Rodrig087/Vertedero-PCh/Software/Arduino/im_circuito_arduino_nokia_5110.jpg

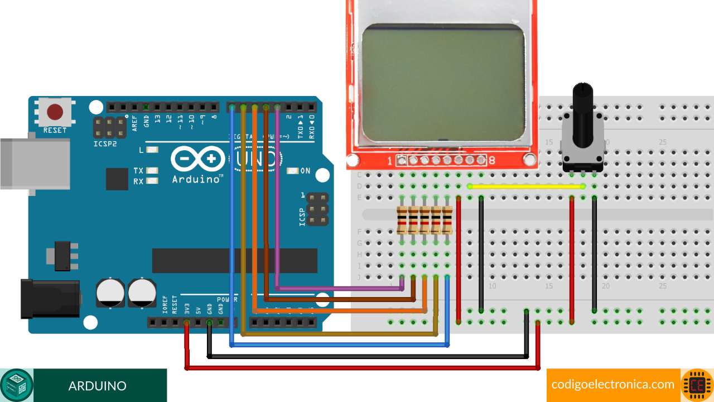
Software/Arduino/im_circuito_arduino_nokia_5110.jpg
