Rodrig087/Vertedero-PCh/LEEME.txt

Este repositorio contiene el firmware para los sensores de nivel del proyecto de monitorizacion de la presa.
