Rodrig087/Vertedero-PCh/Documentacion/Metodos de medicion de TOF.docx

Señal muestreada:

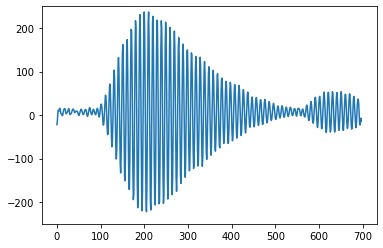
[picture p2: figure]

Método 1:

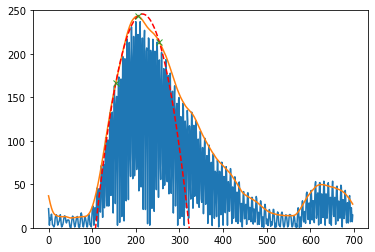
[picture p3: figure]

Método 2:

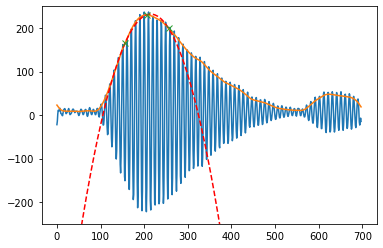
[picture p4: figure]

Método 3:

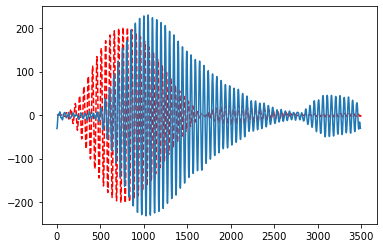
[picture p5: figure]
