Rodrig087/Vertedero-PCh/Software/Arduino/Conexion nokia5110.png

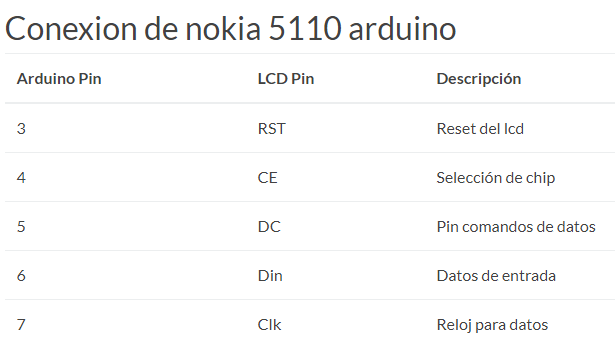
Software/Arduino/Conexion nokia5110.png
