Rodrig087/Vertedero-PCh/Documentacion/Lista de materiales.xlsx

 | Componente | Designador | Valor | Cantidad | Inventario | U1 | U2 | Componente | Valor | Cantidad | U1 | U2
dsPIC | dsPIC | IC2 | dsPIC33FJ32MC202 | 1 | 16 | ORG |  | CI | dsPIC33FJ32MC202 | 1 | ORG
 | Cap electrolitico |  | 10uF | 1 | 134x25V | ORG |  |  | MAX485 | 1 | ORG
 | Cap ceramico |  | 100nF(104) | 2 |  | F23 | CM1 |  | ICL7662CPA | 1 | F25 | CM1
 | Cap ceramico |  | 22pF | 2 | 200 | F14 | CM1 |  | CD4069UBE | 1 | F18 | CM1
 | Cristal |  | 8MHz | 1 | 45 | F15 | CM1 |  | TL974IN | 2 |  | CM1
 | Diodo |  | 1n914 | 1 |  | ORG |  | Zocalos | DIP28 | 1 | ORG | ZOCALOS
 | resistencia |  | 4,7K | 1 |  |  |  |  | DIP8 | 2 | ORG | ZOCALOS
MAX485 | MAXRS485 | IC9 | MAX485 | 1 | 4 | ORG |  |  | DIP14 | 3 | ORG | ZOCALOS
 | resistencia |  | 3,3K | 2 |  |  |  | Resistencias | 120 | 1 | Paquete
 | resistencia |  | 120 | 1 |  |  |  |  | 220 | 2 | Paquete
 | Cap ceramico |  | 100nF(104) | 1 |  | F23 | CM1 |  | 390 | 1 | Paquete
Fuente | regulador +5V | IC1 | LM7805 |  | 60 | ORG |  |  | 470 | 1 | Paquete
 | regulador -5V | IC3 | LM7905CT |  | 10_12_14 | F19 | CM1 |  | 1K | 2 | Paquete
 | regulador 3,3V | IC4 | LM1117MP-3.3 |  | 10 | F19 | CM1 |  | 2,2K | 2 | Paquete
 | regulador conm | IC2* | ICL7662CPA |  | 20 | F25 | CM1 |  | 3,3K | 3 | Paquete
 | Cap ceramico |  | 10nF(103) |  | 585 | F23 | CM1 |  | 4,7K | 2 | No
 | Cap ceramico |  | 100nF(104) |  | varios | F23 | CM1 |  | 10K | 10 | Paquete
 | Cap electrolitico |  | 220uF |  | 180x16V | F14 | CM1 |  | 1M | 1 | Paquete
 | Cap electrolitico |  | 470uF |  | 130x16V | Paquete |  | Trimer | 10k(103) | 1 | ORG
 | Cap electrolitico |  | 10uF | 1 | 134x25V | ORG |  | Cap ceramico | 102 | 3 | F14 | CM1
Temp | ds18b20 |  |  | 1 | contar | Paquete |  |  | 103 | 3+ | F23 | CM1
 | resistencia |  | 4,7K | 1 |  |  |  |  | 104 | 3+ | F23 | CM1
Transductores | hex inverter | IC6 | CD4069UBE | 1 | 10 | F18 | CM1 |  | 22 | 2 | F14 | CM1
 | Cap ceramico |  | 100nF(104) | 1 |  | F23 | CM1 | Cap electrolitico | 10uF |  | ORG
 | RJ11 PCB |  |  | 2 | 60 | F8 | CM1 |  | 220uF |  | F14 | CM1
 | **RJ9 macho |  |  | 2 | 8 | ORG | S/N |  | 470uF |  | Paquete
 | **Transductores |  | HC-SR04 | 1 par | 10 | F4 | CM1 | Varios | Cristal 8MHz | 1 | F15 | CM1
 | amplificador op | IC7 - IC8 | TL974IN | 2 | 18 |  | CM1 |  | Diodo | 1 | ORG
Acoplamiento, preamplificacion, filtrado, amplificacion | Resitencias | R14 | 10K |  | 213 | Paquete |  |  | ds18b20 | 1
 |  | R15 | 10K |  |  |  |  |  | RJ11 PCB | 2 | F8 | CM1
 |  | R16 | 1M |  | 200 | Paquete |  |  | RJ9 macho | 2 | ORG
 |  | R17 | 1K |  | 200 | Paquete
 |  | R18 | 3,3K |  | 200 | Paquete
 |  | R19 | 470 |  | 200 | Paquete
 |  | R20 | 10K
 |  | R21 | 390 |  | 200 | Paquete
 |  | R22 | 220 |  | 200 | Paquete
 |  | R23 | 220
 |  | R25 | 1K
 | Trimmer | R24 | 10K |  | 26(20k-203) | ORG
 | Cap ceramico | C3 | 10nF(103)
 |  | C4 | 10nF(103)
 |  | C5 | 10nF(103)
Acondicionamiento Antialiasing | Resistencias | R28 | 10k
 |  | R29 | 10k
 |  | R30 | 10k
 |  | R31 | 10k
 |  | R32 | 10k
 |  | R33 | 10k
 |  | R34 | 10k
 |  | R35 | 2,2k |  | 200 | Paquete
 |  | R36 | 2,2k
 | Cap ceramico | C6 | 1nF(102) |  | F14 | CM1
 |  | C7 | 1nF(102)
 |  | C8 | 1nF(102)
