Rodrig087/Vertedero-PCh/CAD/Chapa metalica/Frente.SLDPRT

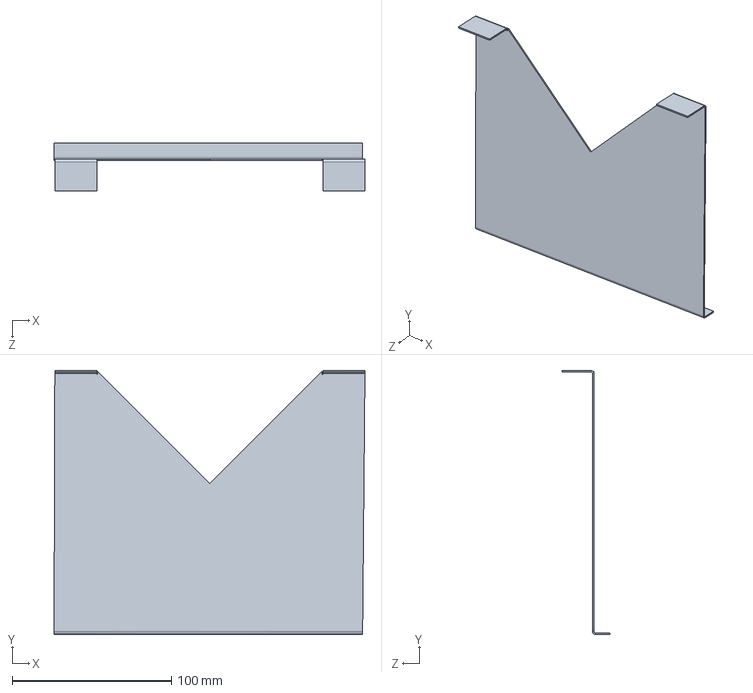
[picture p7: CAD file, 2021-11-26]
CAD/Chapa metalica/Frente.SLDPRT
195.5 x 166.0 x 30.0 mm
