Rodrig087/Vertedero-PCh/CAD/Chapa metalica/Piezas/Solidos/Pieza6.SLDPRT

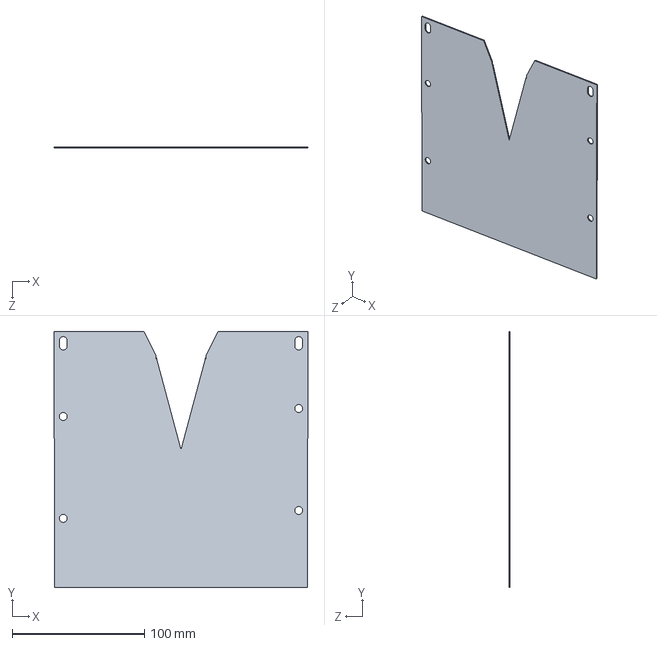
[picture p8: CAD file, 2021-11-26]
CAD/Chapa metalica/Piezas/Solidos/Pieza6.SLDPRT
192.0 x 193.7 x 1.00 mm
