Rodrig087/Vertedero-PCh/CAD/Chapa metalica/Piezas/Solidos/Pieza1.SLDPRT

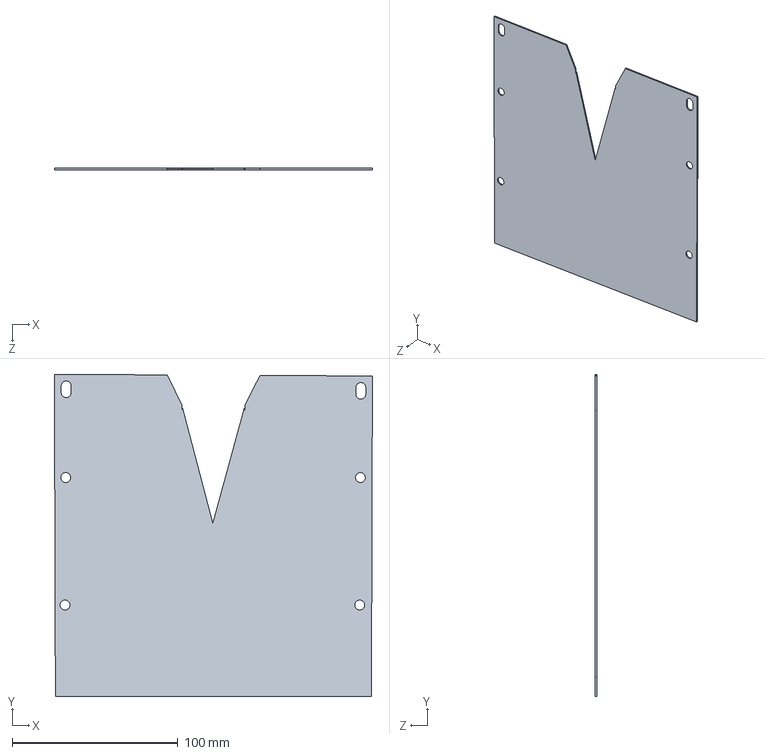
[picture p9: CAD file, 2021-11-26]
CAD/Chapa metalica/Piezas/Solidos/Pieza1.SLDPRT
192.1 x 194.7 x 1.00 mm
