Rodrig087/Vertedero-PCh/CAD/Chapa metalica/Piezas/Solidos/Pieza3.SLDPRT

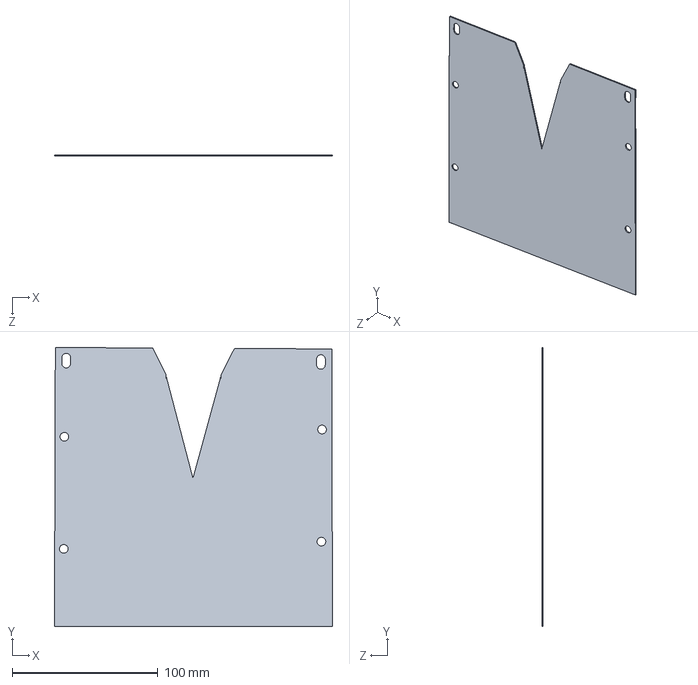
[picture p10: CAD file, 2021-11-26]
CAD/Chapa metalica/Piezas/Solidos/Pieza3.SLDPRT
191.0 x 191.7 x 1.00 mm
