Rodrig087/Vertedero-PCh/CAD/Chapa metalica/Piezas/Solidos/Pieza1 V1.SLDPRT

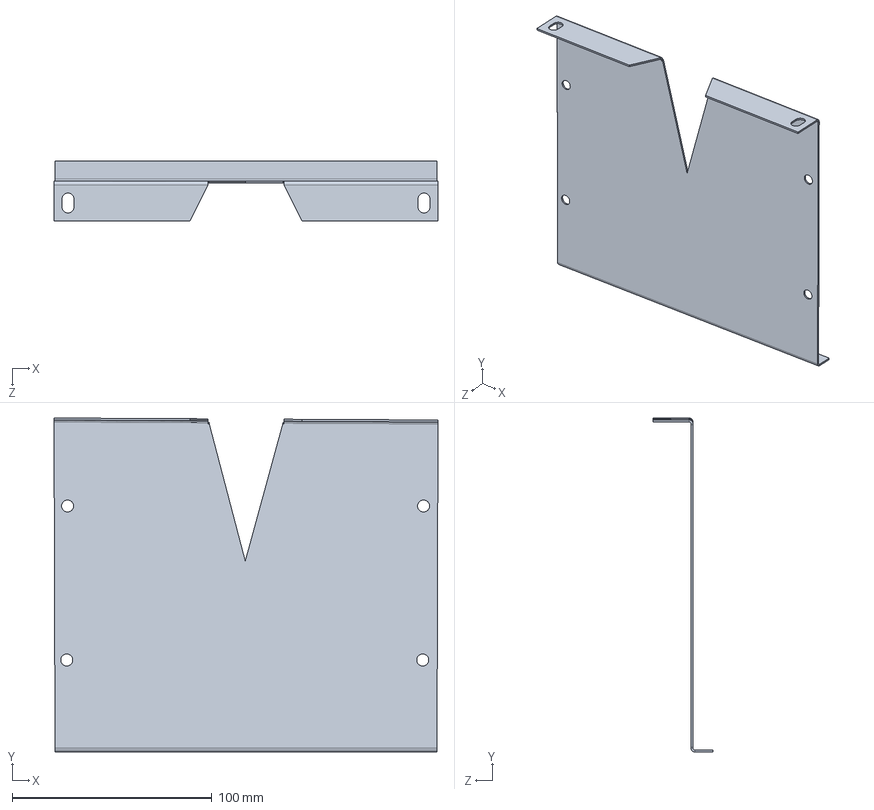
[picture p11: CAD file, 2021-11-26]
CAD/Chapa metalica/Piezas/Solidos/Pieza1 V1.SLDPRT
192.0 x 167.0 x 30.0 mm
