Rodrig087/Vertedero-PCh/(list of files, cad)

Other CAD files:
CAD/Chapa metalica/Piezas/Planos/Pieza6_V90.DWG
CAD/Chapa metalica/Chapa.DWG
CAD/Chapa metalica/Piezas/Planos/Pieza1_V90.DWG
CAD/Chapa metalica/Piezas/Solidos/Pieza5.SLDPRT
CAD/Chapa metalica/Piezas/Planos/Pieza8_V90.DWG
CAD/Chapa metalica/Piezas/Solidos/Pieza2.SLDPRT
CAD/Chapa metalica/Piezas/Solidos/Pieza8.SLDPRT
CAD/Chapa metalica/Piezas/Planos/Pieza5_V90.DWG
CAD/Chapa metalica/Piezas/Solidos/Pieza7.SLDPRT
CAD/Chapa metalica/Piezas/Planos/Pieza2_V90.DWG
CAD/Chapa metalica/Piezas/Solidos/Pieza4.SLDPRT
CAD/Chapa metalica/Piezas/Planos/Pieza7_V90.DWG
CAD/Chapa metalica/Piezas/Planos/Pieza4_V90.DWG
CAD/Chapa metalica/Piezas/Planos/Pieza3_V90.DWG
CAD/Chapa metalica/Chapa.SLDDRW
CAD/Chapa metalica/Piezas/Planos/Pieza1.SLDDRW
CAD/Chapa metalica/Piezas/Planos/Pieza1_V30.DWG
CAD/Chapa metalica/Piezas/Planos/Pieza2.SLDDRW
CAD/Chapa metalica/Piezas/Planos/Pieza2_V30.DWG
CAD/Chapa metalica/Piezas/Planos/Pieza3.SLDDRW
CAD/Chapa metalica/Piezas/Planos/Pieza3_V30.DWG
CAD/Chapa metalica/Piezas/Planos/Pieza4.SLDDRW
CAD/Chapa metalica/Piezas/Planos/Pieza4_V30.DWG
CAD/Chapa metalica/Piezas/Planos/Pieza5.SLDDRW
CAD/Chapa metalica/Piezas/Planos/Pieza5_V30.DWG
CAD/Chapa metalica/Piezas/Planos/Pieza6.SLDDRW
CAD/Chapa metalica/Piezas/Planos/Pieza6_V30.DWG
CAD/Chapa metalica/Piezas/Planos/Pieza7.SLDDRW
CAD/Chapa metalica/Piezas/Planos/Pieza7_V30.DWG
CAD/Chapa metalica/Piezas/Planos/Pieza8.SLDDRW
CAD/Chapa metalica/Piezas/Planos/Pieza8_V30.DWG
