Rodrig087/Vertedero-PCh/Documentacion/Esquema.pdf

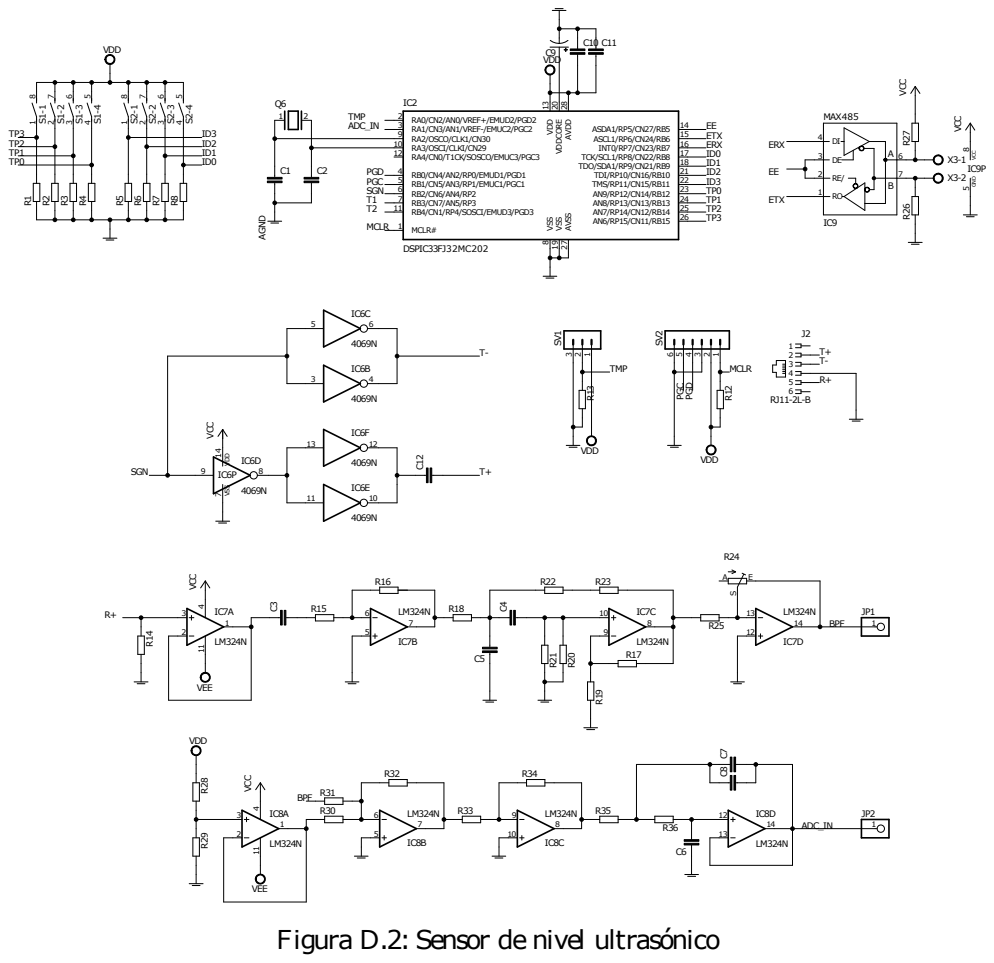
[picture p12: page 1]

Figura D.2: Sensor de nivel ultrasónico
