Rodrig087/Vertedero-PCh/Documentacion/Fuentes.pdf

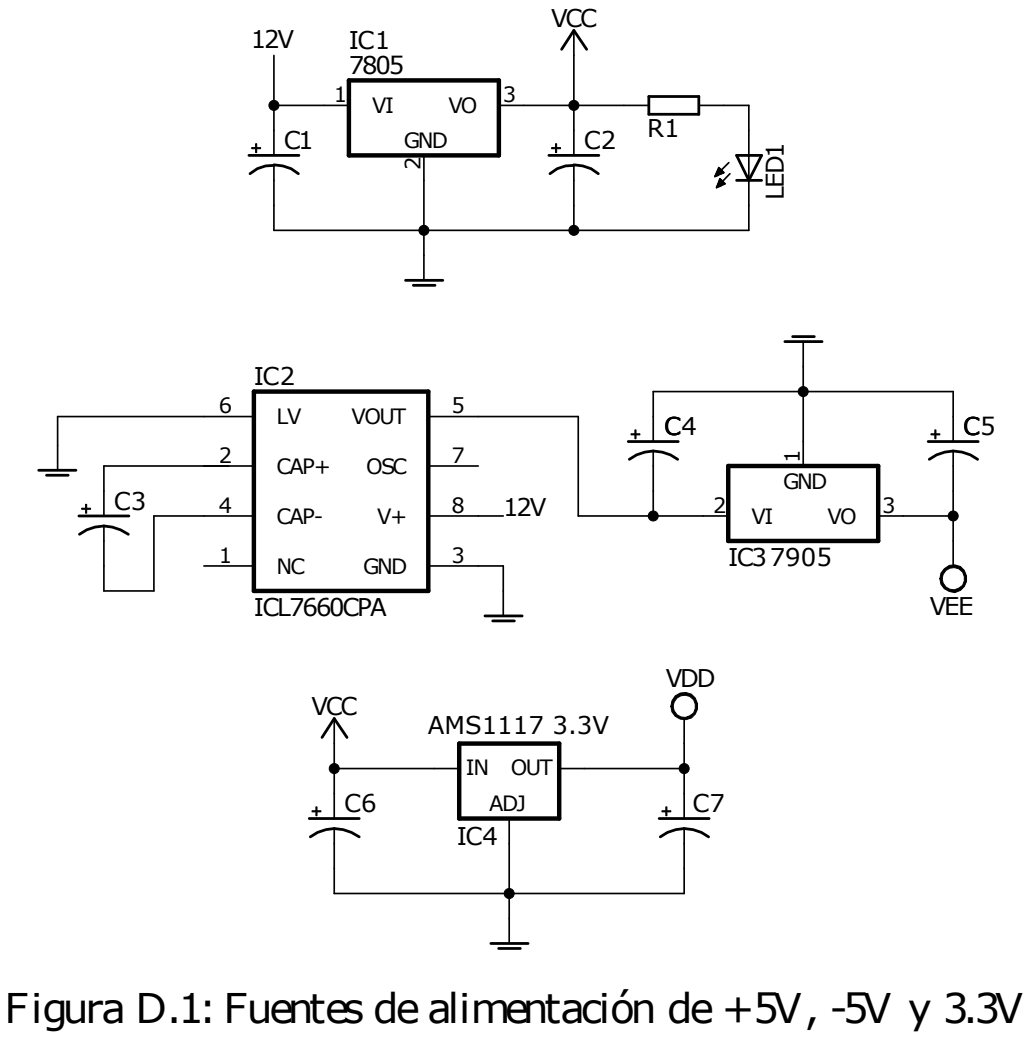
[picture p13: page 1]

Figura D.1: Fuentes de alimentación de +5V, -5V y 3.3V
