Rodrig087/Vertedero-PCh/PCBs/SensorNivel/sensor_dsp.brd

## EAGLE design PCBs/SensorNivel/sensor_dsp.brd (2022-03-25)

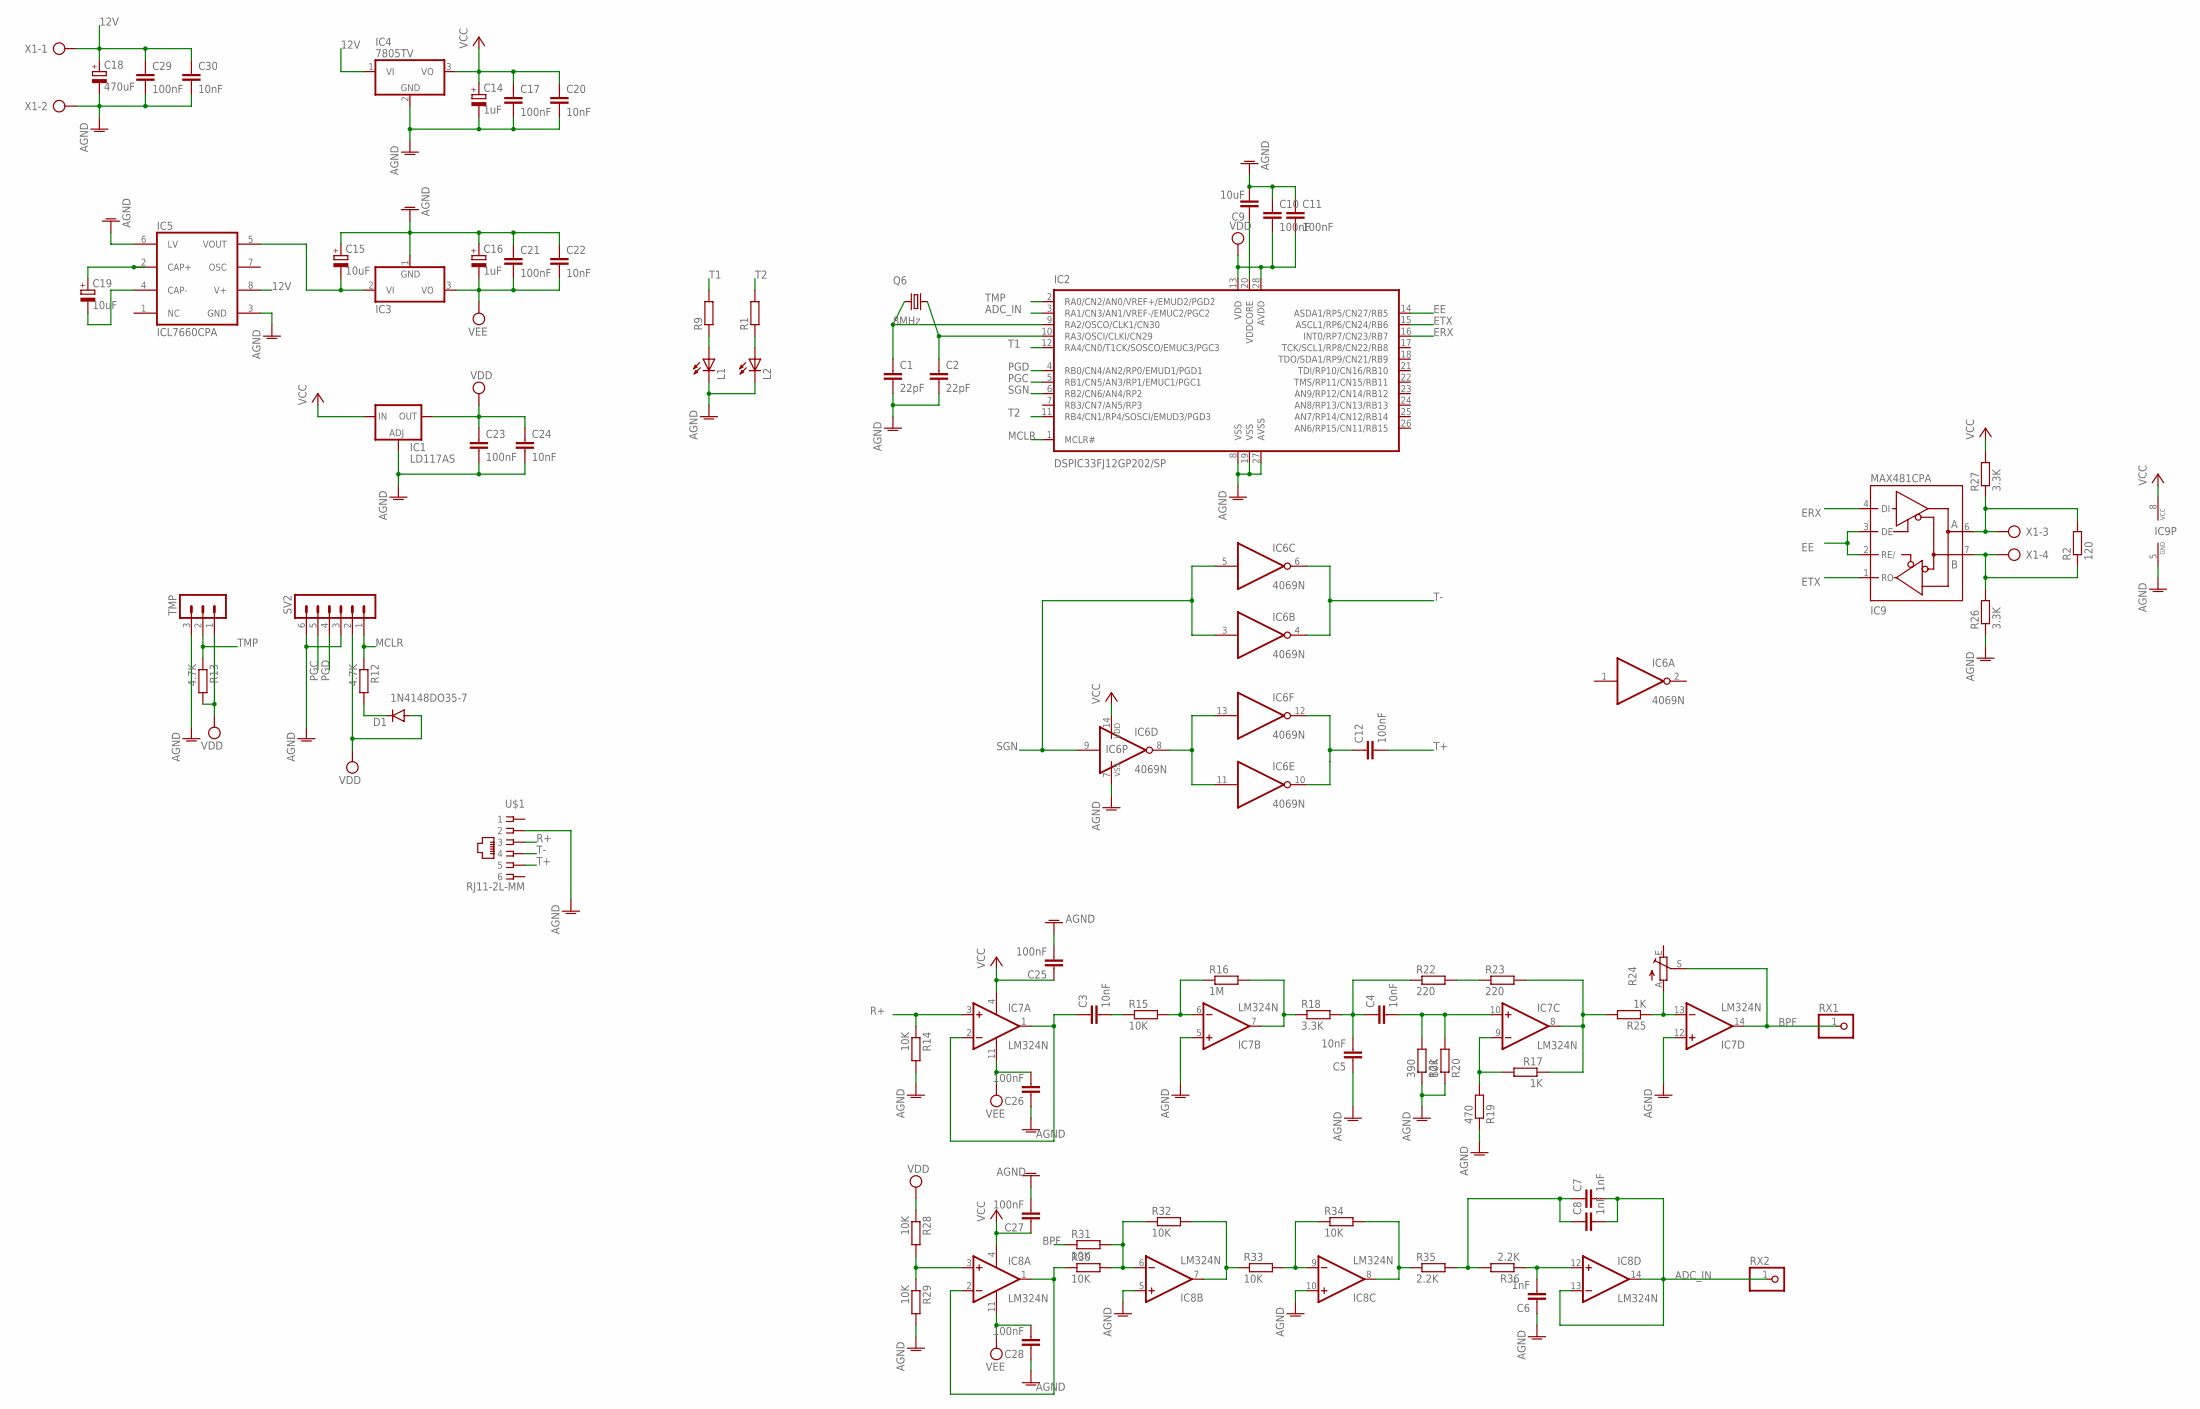
[picture p14: schematic sensor_dsp.sch]

Parts:
C1, C2: 22pF; C025-024X044
C3, C4, C5, C20, C22, C24, C30: 10nF; C5B2.5
C6, C7, C8: 1nF; C5B2.5
C9: 10uF; C050-024X044
C10, C11, C12, C17, C21, C23, C25, C26, C27, C28, C29: 100nF; C5B2.5
C14, C16: 1uF; E2,5-5
C15, C19: 10uF; E2,5-5
C18: 470uF; E3,5-8
D1: 1N4148DO35-7; DO35-7
IC1: LD117AS; SOT223
IC2: DSPIC33FJ12GP202/SP; DIL28-3
IC3: 79; TO220V
IC4: 7805TV; TO220V
IC5: ICL7660CPA; DIL08
IC6: 4069N; DIL14
IC7, IC8: LM324N; DIL14
IC9: MAX481CPA; DIL08
L1, L2: LED3MM
Q6: 8MHz; SM49
R1, R9: R-EU_0204/7; 0204/7
R2: 120; 0204/7
R12, R13: 4.7K; 0204/7
R14, R15, R20, R28, R29, R30, R31, R32, R33, R34: 10K; 0204/7
R16: 1M; 0204/7
R17, R25: 1K; 0204/7
R18, R26, R27: 3.3K; 0204/7
R19: 470; 0204/7
R21: 390; 0204/7
R22, R23: 220; 0204/7
R24: TRIM_EU-B64W; B64W
R35, R36: 2.2K; 0204/7
RX1, RX2: PINHD-1X1; 1X01
SV2: MA06-1
TMP: MA03-1
U$1: RJ11-2L-MM; RJ11-NO_SHIELD_2
X1: AK300/4

Connections:
12V: C18.+, C29.1, C30.1, IC4.1 (VI), IC5.8 (V+), X1.1
A: IC9.6 (A), R2.2, R27.1, X1.3
ADC_IN: C7.2, C8.2, IC2.3 (RA1/CN3/AN1/VREF-/EMUC2/PGC2), IC8.13 (-IN), IC8.14 (OUT), RX2.1
AGND: C1.2, C2.2, C5.1, C6.1, C9.2, C10.1, C11.1, C14.-, C15.+, C16.+, C17.2, C18.-, C20.2, C21.1, C22.1, C23.2, C24.2, C25.2, C26.1, C27.2, C28.1, C29.2, C30.2, IC1.1 (ADJ), IC2.8 (VSS), IC2.19 (VSS), IC2.27 (AVSS), IC3.1 (GND), IC4.2 (GND), IC5.3 (GND), IC5.6 (LV), IC6.7 (VSS), IC7.5 (+IN), IC7.12 (+IN), IC8.5 (+IN), IC8.10 (+IN), IC9.5 (GND), L1.K (C), L2.K (C), R14.2, R19.1, R20.1, R21.1, R26.1, R29.2, SV2.3, SV2.6, TMP.3, U$1.2, X1.2
B: IC9.7 (B), R2.1, R26.2, X1.4
BPF: IC7.14 (OUT), R24.S, R31.1, RX1.1
EE: IC2.14 (ASDA1/RP5/CN27/RB5), IC9.2 (RE/), IC9.3 (DE)
ERX: IC2.16 (INT0/RP7/CN23/RB7), IC9.4 (DI)
ETX: IC2.15 (ASCL1/RP6/CN24/RB6), IC9.1 (RO)
MCLR: IC2.1 (MCLR#), R12.1, SV2.1
unnamed: C9.1, IC2.20 (VDDCORE)
unnamed: C19.+, IC5.2 (CAP+)
unnamed: C15.-, IC3.2 (VI), IC5.5 (VOUT)
unnamed: C1.1, IC2.9 (RA2/OSCO/CLK1/CN30), Q6.1
unnamed: C19.-, IC5.4 (CAP-)
unnamed: L1.A, R9.1
unnamed: C3.1, IC7.1 (OUT), IC7.2 (-IN)
unnamed: C2.1, IC2.10 (RA3/OSCI/CLKI/CN29), Q6.2
unnamed: IC7.6 (-IN), R15.2, R16.1
unnamed: D1.C, R12.2
unnamed: IC6.8 (O), IC6.11 (I), IC6.13 (I)
unnamed: C12.1, IC6.10 (O), IC6.12 (O)
unnamed: IC7.7 (OUT), R16.2, R18.1
unnamed: C3.2, R15.1
unnamed: IC7.8 (OUT), R17.1, R23.2, R25.2
unnamed: IC7.9 (-IN), R17.2, R19.2
unnamed: C4.2, IC7.10 (+IN), R20.2, R21.2
unnamed: IC8.1 (OUT), IC8.2 (-IN), R30.1
unnamed: C4.1, C5.2, R18.2, R22.1
unnamed: R22.2, R23.1
unnamed: IC7.13 (-IN), R24.A, R25.1
unnamed: IC8.3 (+IN), R28.2, R29.1
unnamed: IC8.6 (-IN), R30.2, R31.2, R32.1
unnamed: IC8.7 (OUT), R32.2, R33.1
unnamed: IC8.9 (-IN), R33.2, R34.1
unnamed: IC8.8 (OUT), R34.2, R35.1
unnamed: L2.A, R1.1
unnamed: C7.1, C8.1, R35.2, R36.2
unnamed: C6.2, IC8.12 (+IN), R36.1
PGC: IC2.5 (RB1/CN5/AN3/RP1/EMUC1/PGC1), SV2.5
PGD: IC2.4 (RB0/CN4/AN2/RP0/EMUD1/PGD1), SV2.4
R+: IC7.3 (+IN), R14.1, U$1.3
SGN: IC2.6 (RB2/CN6/AN4/RP2), IC6.3 (I), IC6.5 (I), IC6.9 (I)
T1: IC2.12 (RA4/CN0/T1CK/SOSCO/EMUC3/PGC3), R9.2
T2: IC2.11 (RB4/CN1/RP4/SOSCI/EMUD3/PGD3), R1.2
T+: C12.2, U$1.5
T-: IC6.4 (O), IC6.6 (O), U$1.4
TMP: IC2.2 (RA0/CN2/AN0/VREF+/EMUD2/PGD2), R13.1, TMP.2
VCC: C14.+, C17.1, C20.1, C25.1, C27.1, IC1.3 (IN), IC4.3 (VO), IC6.14 (VDD), IC7.4 (V+), IC8.4 (V+), IC9.8 (VCC), R27.2
VDD: C10.2, C11.2, C23.1, C24.1, D1.A, IC1.4 (OUT), IC2.13 (VDD), IC2.28 (AVDD), R13.2, R28.1, SV2.2, TMP.1
VEE: C16.-, C21.2, C22.2, C26.2, C28.2, IC3.3 (VO), IC7.11 (V-), IC8.11 (V-)

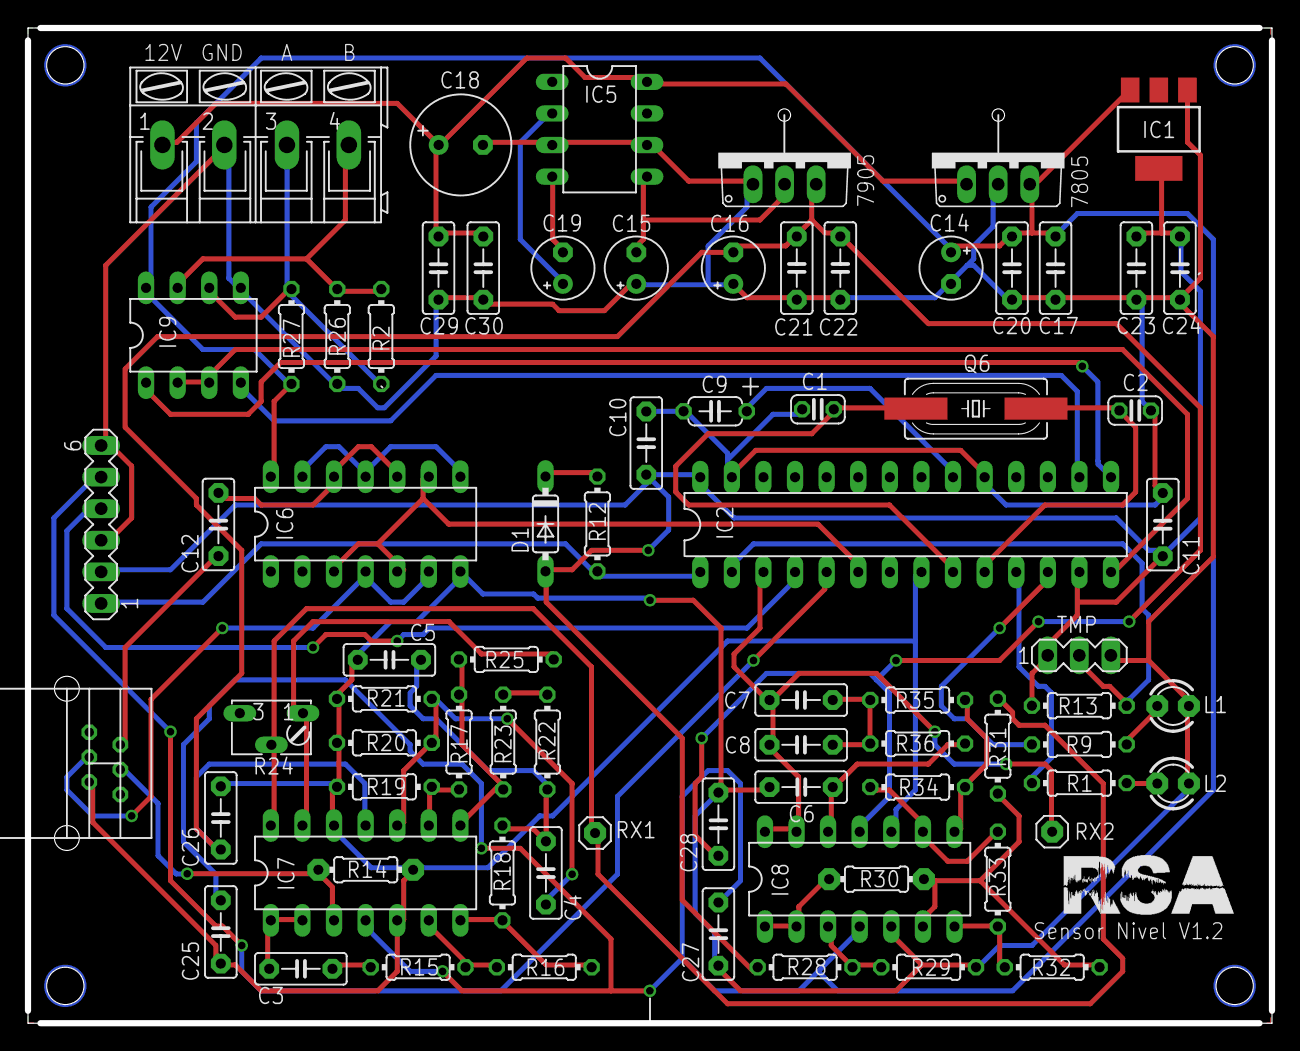
[picture p15: board sensor_dsp.brd from above]

Board: 2 copper layers, 100.0 x 80.0 mm, 76 parts (0 on the bottom side), 51 nets.
