Rodrig087/Vertedero-PCh/PCBs/TransductorV3/Trd_pcb.brd

## EAGLE design PCBs/TransductorV3/Trd_pcb.brd (2021-11-26)

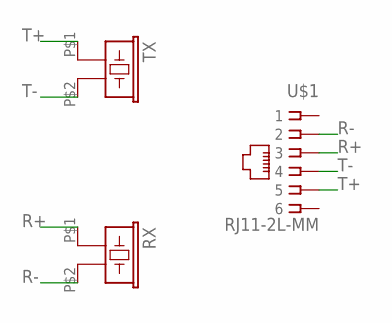
[picture p16: schematic Trd_pcb.sch]

Parts:
RX: 400ST/R100; DIA-9.7-5
TX: 400ST/R100; DIA-9.7-5
U$1: RJ11-2L-MM; RJ11-NO_SHIELD_2

Connections:
R+: RX.P$1 (1), U$1.3
R-: RX.P$2 (2), U$1.2
T+: TX.P$1 (1), U$1.5
T-: TX.P$2 (2), U$1.4

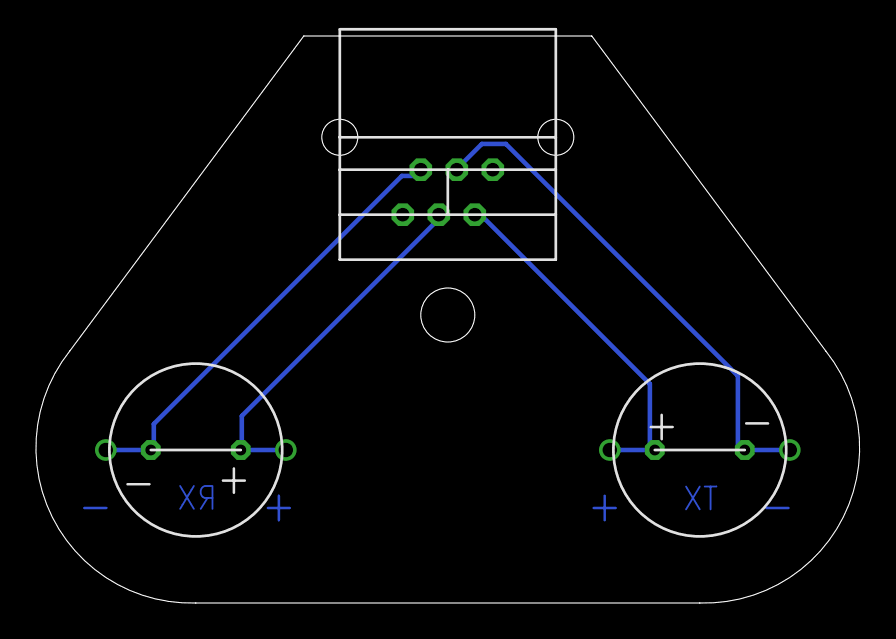
[picture p17: board Trd_pcb.brd from above]

Board: 2 copper layers, 45.8 x 31.5 mm, 3 parts (0 on the bottom side), 4 nets.
