Rodrig087/Vertedero-PCh/Firmware/SensorNivel/SensorNivel.asm

_EnviarTramaRS485:
	LNK	#2

;rs485.c,19 :: 		void EnviarTramaRS485(unsigned char puertoUART, unsigned char *cabecera, unsigned char *payload){
;rs485.c,31 :: 		ptrnumDatos = (unsigned char *) & numDatos;
	PUSH	W10
	ADD	W14, #0, W2
; ptrnumDatos start address is: 6 (W3)
	MOV	W2, W3
;rs485.c,34 :: 		direccion = cabecera[0];
; direccion start address is: 8 (W4)
	MOV.B	[W11], W4
;rs485.c,35 :: 		funcion = cabecera[1];
	ADD	W11, #1, W0
; funcion start address is: 10 (W5)
	MOV.B	[W0], W5
;rs485.c,36 :: 		subfuncion = cabecera[2];
	ADD	W11, #2, W0
; subfuncion start address is: 12 (W6)
	MOV.B	[W0], W6
;rs485.c,37 :: 		lsbNumDatos = cabecera[3];
	ADD	W11, #3, W1
; lsbNumDatos start address is: 14 (W7)
	MOV.B	[W1], W7
;rs485.c,38 :: 		msbNumDatos = cabecera[4];
	ADD	W11, #4, W0
; msbNumDatos start address is: 16 (W8)
	MOV.B	[W0], W8
;rs485.c,41 :: 		*(ptrnumDatos) = lsbNumDatos;
	MOV.B	[W1], [W2]
;rs485.c,42 :: 		*(ptrnumDatos+1) = msbNumDatos;
	ADD	W3, #1, W0
; ptrnumDatos end address is: 6 (W3)
	MOV.B	W8, [W0]
;rs485.c,44 :: 		if (puertoUART == 1){
	CP.B	W10, #1
	BRA Z	L__EnviarTramaRS485119
	GOTO	L_EnviarTramaRS4850
L__EnviarTramaRS485119:
;rs485.c,45 :: 		MSRS485 = 1;                                                            //Establece el Max485 en modo escritura
	BSET	MSRS485, BitPos(MSRS485+0)
;rs485.c,46 :: 		UART1_Write(0x3A);                                                      //Envia la cabecera de la trama
	MOV	#58, W10
	CALL	_UART1_Write
;rs485.c,47 :: 		UART1_Write(direccion);                                                 //Envia la direccion del destinatario
	ZE	W4, W10
; direccion end address is: 8 (W4)
	CALL	_UART1_Write
;rs485.c,48 :: 		UART1_Write(funcion);                                                   //Envia el codigo de la funcion
	ZE	W5, W10
; funcion end address is: 10 (W5)
	CALL	_UART1_Write
;rs485.c,49 :: 		UART1_Write(subfuncion);                                                //Envia el codigo de la subfuncion
	ZE	W6, W10
; subfuncion end address is: 12 (W6)
	CALL	_UART1_Write
;rs485.c,50 :: 		UART1_Write(lsbNumDatos);                                               //Envia el LSB del numero de datos
	ZE	W7, W10
; lsbNumDatos end address is: 14 (W7)
	CALL	_UART1_Write
;rs485.c,51 :: 		UART1_Write(msbNumDatos);                                               //Envia el MSB del numero de datos
	ZE	W8, W10
; msbNumDatos end address is: 16 (W8)
	CALL	_UART1_Write
;rs485.c,52 :: 		for (iDatos=0;iDatos<numDatos;iDatos++){                                //Envia la carga util de datos
; iDatos start address is: 2 (W1)
	CLR	W1
; iDatos end address is: 2 (W1)
L_EnviarTramaRS4851:
; iDatos start address is: 2 (W1)
	ADD	W14, #0, W0
	CP	W1, [W0]
	BRA LTU	L__EnviarTramaRS485120
	GOTO	L_EnviarTramaRS4852
L__EnviarTramaRS485120:
;rs485.c,53 :: 		UART1_Write(payload[iDatos]);
	ADD	W12, W1, W0
	PUSH	W10
	ZE	[W0], W10
	CALL	_UART1_Write
	POP	W10
;rs485.c,52 :: 		for (iDatos=0;iDatos<numDatos;iDatos++){                                //Envia la carga util de datos
	INC	W1
;rs485.c,54 :: 		}
; iDatos end address is: 2 (W1)
	GOTO	L_EnviarTramaRS4851
L_EnviarTramaRS4852:
;rs485.c,55 :: 		UART1_Write(0x0D);                                                      //Envia el primer delimitador de final de la trama
	PUSH	W10
	MOV	#13, W10
	CALL	_UART1_Write
;rs485.c,56 :: 		UART1_Write(0x0A);                                                      //Envia el segundo delimitador de final de la trama
	MOV	#10, W10
	CALL	_UART1_Write
;rs485.c,57 :: 		UART1_Write(0x00);                                                      //Envia un byte adicional
	CLR	W10
	CALL	_UART1_Write
	POP	W10
;rs485.c,58 :: 		while(UART1_Tx_Idle()==0);                                              //Espera hasta que se haya terminado de enviar todo el dato por UART antes de continuar
L_EnviarTramaRS4854:
	CALL	_UART1_Tx_Idle
	CP	W0, #0
	BRA Z	L__EnviarTramaRS485121
	GOTO	L_EnviarTramaRS4855
L__EnviarTramaRS485121:
	GOTO	L_EnviarTramaRS4854
L_EnviarTramaRS4855:
;rs485.c,59 :: 		MSRS485 = 0;                                                           //Establece el Max485 en modo lectura
	BCLR	MSRS485, BitPos(MSRS485+0)
;rs485.c,60 :: 		}
L_EnviarTramaRS4850:
;rs485.c,62 :: 		}
L_end_EnviarTramaRS485:
	POP	W10
	ULNK
	RETURN
; end of _EnviarTramaRS485

_main:
	MOV	#2048, W15
	MOV	#6142, W0
	MOV	WREG, 32
	MOV	#1, W0
	MOV	WREG, 52
	MOV	#4, W0
	IOR	68

;SensorNivel.c,157 :: 		void main() {
;SensorNivel.c,160 :: 		ConfiguracionPrincipal();
	PUSH	W10
	PUSH	W11
	CALL	_ConfiguracionPrincipal
;SensorNivel.c,164 :: 		i = 0;
	CLR	W0
	MOV	W0, _i
;SensorNivel.c,165 :: 		j = 0;
	CLR	W0
	MOV	W0, _j
;SensorNivel.c,166 :: 		x = 0;
	CLR	W0
	MOV	W0, _x
;SensorNivel.c,167 :: 		y = 0;
	CLR	W0
	MOV	W0, _y
;SensorNivel.c,170 :: 		T2 = 0;
	CLR	W0
	CLR	W1
	MOV	W0, _T2
	MOV	W1, _T2+2
;SensorNivel.c,171 :: 		bm = 0;
	MOV	#lo_addr(_bm), W1
	CLR	W0
	MOV.B	W0, [W1]
;SensorNivel.c,172 :: 		TOF = 0;
	CLR	W0
	CLR	W1
	MOV	W0, _TOF
	MOV	W1, _TOF+2
;SensorNivel.c,173 :: 		temperaturaRaw = 0;
	CLR	W0
	MOV	W0, _temperaturaRaw
;SensorNivel.c,174 :: 		pulsosDistancia = 110;
	MOV	#lo_addr(_pulsosDistancia), W1
	MOV.B	#110, W0
	MOV.B	W0, [W1]
;SensorNivel.c,177 :: 		banRSI = 0;
	MOV	#lo_addr(_banRSI), W1
	CLR	W0
	MOV.B	W0, [W1]
;SensorNivel.c,178 :: 		banRSC = 0;
	MOV	#lo_addr(_banRSC), W1
	CLR	W0
	MOV.B	W0, [W1]
;SensorNivel.c,179 :: 		byteRS485 = 0;
	MOV	#lo_addr(_byteRS485), W1
	CLR	W0
	MOV.B	W0, [W1]
;SensorNivel.c,180 :: 		i_rs485 = 0;
	CLR	W0
	MOV	W0, _i_rs485
;SensorNivel.c,181 :: 		funcionRS485 = 0;
	MOV	#lo_addr(_funcionRS485), W1
	CLR	W0
	MOV.B	W0, [W1]
;SensorNivel.c,182 :: 		subFuncionRS485 = 0;
	MOV	#lo_addr(_subFuncionRS485), W1
	CLR	W0
	MOV.B	W0, [W1]
;SensorNivel.c,183 :: 		numDatosRS485 = 0;
	CLR	W0
	MOV	W0, _numDatosRS485
;SensorNivel.c,184 :: 		ptrNumDatosRS485 = (unsigned char *) & numDatosRS485;
	MOV	#lo_addr(_numDatosRS485), W0
	MOV	W0, _ptrNumDatosRS485
;SensorNivel.c,185 :: 		MSRS485 = 0;
	BCLR	LATB5_bit, BitPos(LATB5_bit+0)
;SensorNivel.c,186 :: 		contTMR3 = 0;
	MOV	#lo_addr(_contTMR3), W1
	CLR	W0
	MOV.B	W0, [W1]
;SensorNivel.c,189 :: 		banderaPeticion = 0;
	MOV	#lo_addr(_banderaPeticion), W1
	CLR	W0
	MOV.B	W0, [W1]
;SensorNivel.c,190 :: 		banderaUART = 0;
	MOV	#lo_addr(_banderaUART), W1
	CLR	W0
	MOV.B	W0, [W1]
;SensorNivel.c,193 :: 		LED1 = 0;
	BCLR	LATA4_bit, BitPos(LATA4_bit+0)
;SensorNivel.c,194 :: 		LED2 = 1;
	BSET	LATB4_bit, BitPos(LATB4_bit+0)
;SensorNivel.c,196 :: 		ip=0;
	MOV	#lo_addr(_ip), W1
	CLR	W0
	MOV.B	W0, [W1]
;SensorNivel.c,199 :: 		while(1){
L_main6:
;SensorNivel.c,200 :: 		if (banderaPeticion==1){
	MOV	#lo_addr(_banderaPeticion), W0
	MOV.B	[W0], W0
	CP.B	W0, #1
	BRA Z	L__main123
	GOTO	L_main8
L__main123:
;SensorNivel.c,202 :: 		ProcesarSolicitud(solicitudCabeceraRS485, solicitudPyloadRS485);
	MOV	#lo_addr(_solicitudPyloadRS485), W11
	MOV	#lo_addr(_solicitudCabeceraRS485), W10
	CALL	_ProcesarSolicitud
;SensorNivel.c,204 :: 		}
L_main8:
;SensorNivel.c,205 :: 		}
	GOTO	L_main6
;SensorNivel.c,208 :: 		}
L_end_main:
	POP	W11
	POP	W10
L__main_end_loop:
	BRA	L__main_end_loop
; end of _main

_ConfiguracionPrincipal:

;SensorNivel.c,216 :: 		void ConfiguracionPrincipal(){
;SensorNivel.c,219 :: 		CLKDIVbits.PLLPRE = 0;                                                     //PLLPRE<4:0> = 0  ->  N1 = 2    8MHz / 2 = 4MHz
	PUSH	W10
	PUSH	W11
	MOV	#lo_addr(CLKDIVbits), W0
	MOV.B	[W0], W1
	MOV.B	#224, W0
	AND.B	W1, W0, W1
	MOV	#lo_addr(CLKDIVbits), W0
	MOV.B	W1, [W0]
;SensorNivel.c,220 :: 		PLLFBD = 38;                                                               //PLLDIV<8:0> = 38 ->  M = 40    4MHz * 40 = 160MHz
	MOV	#38, W0
	MOV	WREG, PLLFBD
;SensorNivel.c,221 :: 		CLKDIVbits.PLLPOST = 0;                                                    //PLLPOST<1:0> = 0 ->  N2 = 2    160MHz / 2 = 80MHz
	MOV	#lo_addr(CLKDIVbits), W0
	MOV.B	[W0], W1
	MOV.B	#63, W0
	AND.B	W1, W0, W1
	MOV	#lo_addr(CLKDIVbits), W0
	MOV.B	W1, [W0]
;SensorNivel.c,224 :: 		AD1PCFGL = 0xFFFD;                                                         //Configura el puerto AN1 como entrada analogica y todas las demas como digitales
	MOV	#65533, W0
	MOV	WREG, AD1PCFGL
;SensorNivel.c,225 :: 		TRISA1_bit = 1;                                                            //Establece el pin RA1 como entrada
	BSET	TRISA1_bit, BitPos(TRISA1_bit+0)
;SensorNivel.c,226 :: 		TRISB = 0xFF40;                                                            //TRISB = 11111111 01000000
	MOV	#65344, W0
	MOV	WREG, TRISB
;SensorNivel.c,227 :: 		MSRS485_Direction = 0;                                                     //MSRS485 out
	BCLR	TRISB5_bit, BitPos(TRISB5_bit+0)
;SensorNivel.c,228 :: 		LED1_Direction = 0;                                                        //LED1 out
	BCLR	TRISA4_bit, BitPos(TRISA4_bit+0)
;SensorNivel.c,230 :: 		AD1CON1.AD12B = 0;                                                         //Configura el ADC en modo de 10 bits
	BCLR	AD1CON1, #10
;SensorNivel.c,231 :: 		AD1CON1bits.FORM = 0x00;                                                   //Formato de la canversion: 00->(0_1023)|01->(-512_511)|02->(0_0.999)|03->(-1_0.999)
	MOV	AD1CON1bits, W1
	MOV	#64767, W0
	AND	W1, W0, W0
	MOV	WREG, AD1CON1bits
;SensorNivel.c,232 :: 		AD1CON1.SIMSAM = 0;                                                        //0 -> Muestrea multiples canales individualmente en secuencia
	BCLR	AD1CON1, #3
;SensorNivel.c,233 :: 		AD1CON1.ADSIDL = 0;                                                        //Continua con la operacion del modulo durante el modo desocupado
	BCLR	AD1CON1, #13
;SensorNivel.c,234 :: 		AD1CON1.ASAM = 1;                                                          //Muestreo automatico
	BSET	AD1CON1, #2
;SensorNivel.c,235 :: 		AD1CON1bits.SSRC = 0x00;                                                   //Conversion manual
	MOV	#lo_addr(AD1CON1bits), W0
	MOV.B	[W0], W1
	MOV.B	#31, W0
	AND.B	W1, W0, W1
	MOV	#lo_addr(AD1CON1bits), W0
	MOV.B	W1, [W0]
;SensorNivel.c,236 :: 		AD1CON2bits.VCFG = 0;                                                      //Selecciona AVDD y AVSS como fuentes de voltaje de referencia
	MOV	AD1CON2bits, W1
	MOV	#8191, W0
	AND	W1, W0, W0
	MOV	WREG, AD1CON2bits
;SensorNivel.c,237 :: 		AD1CON2bits.CHPS = 0;                                                      //Selecciona unicamente el canal CH0
	MOV	AD1CON2bits, W1
	MOV	#64767, W0
	AND	W1, W0, W0
	MOV	WREG, AD1CON2bits
;SensorNivel.c,238 :: 		AD1CON2.CSCNA = 0;                                                         //No escanea las entradas de CH0 durante la Muestra A
	BCLR	AD1CON2, #10
;SensorNivel.c,239 :: 		AD1CON2.BUFM = 0;                                                          //Bit de seleccion del modo de relleno del bufer, 0 -> Siempre comienza a llenar el buffer desde el principio
	BCLR	AD1CON2, #1
;SensorNivel.c,240 :: 		AD1CON2.ALTS = 0x00;                                                       //Utiliza siempre la seleccion de entrada de canal para la muestra A
	BCLR	AD1CON2, #0
;SensorNivel.c,241 :: 		AD1CON3.ADRC = 0;                                                          //Selecciona el reloj de conversion del ADC derivado del reloj del sistema
	BCLR	AD1CON3, #15
;SensorNivel.c,242 :: 		AD1CON3bits.ADCS = 0x02;                                                   //Configura el periodo del reloj del ADC fijando el valor de los bits ADCS segun la formula: TAD = TCY*(ADCS+1) = 75ns  -> ADCS = 2
	MOV.B	#2, W0
	MOV.B	W0, W1
	MOV	#lo_addr(AD1CON3bits), W0
	XOR.B	W1, [W0], W1
	MOV.B	#255, W0
	AND.B	W1, W0, W1
	MOV	#lo_addr(AD1CON3bits), W0
	XOR.B	W1, [W0], W1
	MOV	#lo_addr(AD1CON3bits), W0
	MOV.B	W1, [W0]
;SensorNivel.c,243 :: 		AD1CON3bits.SAMC = 0x02;                                                   //Auto Sample Time bits, 2 -> 2*TAD (minimo periodo de muestreo para 10 bits)
	MOV	#512, W0
	MOV	W0, W1
	MOV	#lo_addr(AD1CON3bits), W0
	XOR	W1, [W0], W1
	MOV	#7936, W0
	AND	W1, W0, W1
	MOV	#lo_addr(AD1CON3bits), W0
	XOR	W1, [W0], W1
	MOV	W1, AD1CON3bits
;SensorNivel.c,244 :: 		AD1CHS0.CH0NB = 0;                                                         //Channel 0 negative input is VREF-
	BCLR	AD1CHS0, #15
;SensorNivel.c,245 :: 		AD1CHS0bits.CH0SB = 0x01;                                                  //Channel 0 positive input is AN1
	MOV	#256, W0
	MOV	W0, W1
	MOV	#lo_addr(AD1CHS0bits), W0
	XOR	W1, [W0], W1
	MOV	#7936, W0
	AND	W1, W0, W1
	MOV	#lo_addr(AD1CHS0bits), W0
	XOR	W1, [W0], W1
	MOV	W1, AD1CHS0bits
;SensorNivel.c,246 :: 		AD1CHS0.CH0NA = 0;                                                         //Channel 0 negative input is VREF-
	BCLR	AD1CHS0, #7
;SensorNivel.c,247 :: 		AD1CHS0bits.CH0SA = 0x01;                                                  //Channel 0 positive input is AN1
	MOV.B	#1, W0
	MOV.B	W0, W1
	MOV	#lo_addr(AD1CHS0bits), W0
	XOR.B	W1, [W0], W1
	AND.B	W1, #31, W1
	MOV	#lo_addr(AD1CHS0bits), W0
	XOR.B	W1, [W0], W1
	MOV	#lo_addr(AD1CHS0bits), W0
	MOV.B	W1, [W0]
;SensorNivel.c,248 :: 		AD1CHS123 = 0;                                                             //AD1CHS123: ADC1 INPUT CHANNEL 1, 2, 3 SELECT REGISTER
	CLR	AD1CHS123
;SensorNivel.c,249 :: 		AD1CSSL = 0x00;                                                            //Se salta todos los puertos ANx para los escaneos de entrada
	CLR	AD1CSSL
;SensorNivel.c,250 :: 		AD1CON1.ADON = 1;                                                          //Enciende el modulo ADC
	BSET	AD1CON1, #15
;SensorNivel.c,253 :: 		T1CON = 0x8000;                                                            //Habilita el TMR1, selecciona el reloj interno, desabilita el modo Gated Timer, selecciona el preescalador 1:1,
	MOV	#32768, W0
	MOV	WREG, T1CON
;SensorNivel.c,254 :: 		IEC0.T1IE = 1;                                                             //Habilita la interrupcion por desborde de TMR1
	BSET	IEC0, #3
;SensorNivel.c,255 :: 		T1IF_bit = 0;                                                              //Limpia la bandera de interrupcion
	BCLR	T1IF_bit, BitPos(T1IF_bit+0)
;SensorNivel.c,256 :: 		PR1 = 200;                                                                 //Genera una interrupcion cada 5us (Fs=200KHz)
	MOV	#200, W0
	MOV	WREG, PR1
;SensorNivel.c,257 :: 		T1CON.TON = 0;                                                             //Apaga la interrupcion
	BCLR	T1CON, #15
;SensorNivel.c,260 :: 		T2CON = 0x8000;                                                            //Habilita el TMR2, selecciona el reloj interno, desabilita el modo Gated Timer, selecciona el preescalador 1:1,
	MOV	#32768, W0
	MOV	WREG, T2CON
;SensorNivel.c,261 :: 		IEC0.T2IE = 1;                                                             //Habilita la interrupcion por desborde de TMR2
	BSET	IEC0, #7
;SensorNivel.c,262 :: 		T2IF_bit = 0;                                                              //Limpia la bandera de interrupcion
	BCLR	T2IF_bit, BitPos(T2IF_bit+0)
;SensorNivel.c,263 :: 		PR2 = 500;                                                                 //Genera una interrupcion cada 12.5us
	MOV	#500, W0
	MOV	WREG, PR2
;SensorNivel.c,264 :: 		T2CON.TON = 0;                                                             //Apaga la interrupcion
	BCLR	T2CON, #15
;SensorNivel.c,268 :: 		T3CON = 0x8030;                                                            //Habilita el TMR3
	MOV	#32816, W0
	MOV	WREG, T3CON
;SensorNivel.c,269 :: 		IEC0.T3IE = 1;                                                             //Habilita la interrupcion por desborde de TMR3
	BSET	IEC0, #8
;SensorNivel.c,270 :: 		T3IF_bit = 0;                                                              //Limpia la bandera de interrupcion
	BCLR	T3IF_bit, BitPos(T3IF_bit+0)
;SensorNivel.c,271 :: 		PR3 = 46875;                                                               //Genera una interrupcion cada 300ms
	MOV	#46875, W0
	MOV	WREG, PR3
;SensorNivel.c,272 :: 		T3CON.TON = 0;                                                             //Apaga la interrupcion
	BCLR	T3CON, #15
;SensorNivel.c,276 :: 		RPINR18bits.U1RXR = 0x06;                                                  //Asisgna Rx a RP6
	MOV.B	#6, W0
	MOV.B	W0, W1
	MOV	#lo_addr(RPINR18bits), W0
	XOR.B	W1, [W0], W1
	AND.B	W1, #31, W1
	MOV	#lo_addr(RPINR18bits), W0
	XOR.B	W1, [W0], W1
	MOV	#lo_addr(RPINR18bits), W0
	MOV.B	W1, [W0]
;SensorNivel.c,277 :: 		RPOR3bits.RP7R = 0x03;                                                     //Asigna Tx a RP7
	MOV	#768, W0
	MOV	W0, W1
	MOV	#lo_addr(RPOR3bits), W0
	XOR	W1, [W0], W1
	MOV	#7936, W0
	AND	W1, W0, W1
	MOV	#lo_addr(RPOR3bits), W0
	XOR	W1, [W0], W1
	MOV	W1, RPOR3bits
;SensorNivel.c,278 :: 		IEC0.U1RXIE = 1;                                                           //Habilita la interrupcion por recepcion de dato por UART
	BSET	IEC0, #11
;SensorNivel.c,279 :: 		U1RXIF_bit = 0;                                                            //Limpia la bandera de interrupcion de UARTRX
	BCLR	U1RXIF_bit, BitPos(U1RXIF_bit+0)
;SensorNivel.c,280 :: 		UART1_Init(19200);                                                         //Inicializa el modulo UART a 9600 bps
	MOV	#19200, W10
	MOV	#0, W11
	CALL	_UART1_Init
;SensorNivel.c,283 :: 		IPC0bits.T1IP = 0x07;                                                      //Nivel de prioridad de la interrupcion por desbordamiento del TMR1
	MOV	IPC0bits, W1
	MOV	#28672, W0
	IOR	W1, W0, W0
	MOV	WREG, IPC0bits
;SensorNivel.c,284 :: 		IPC1bits.T2IP = 0x06;                                                      //Nivel de prioridad de la interrupcion por desbordamiento del TMR2
	MOV	#24576, W0
	MOV	W0, W1
	MOV	#lo_addr(IPC1bits), W0
	XOR	W1, [W0], W1
	MOV	#28672, W0
	AND	W1, W0, W1
	MOV	#lo_addr(IPC1bits), W0
	XOR	W1, [W0], W1
	MOV	W1, IPC1bits
;SensorNivel.c,286 :: 		IPC2bits.U1RXIP = 0x05;                                                    //Nivel de prioridad de la interrupcion UARTRX
	MOV	#20480, W0
	MOV	W0, W1
	MOV	#lo_addr(IPC2bits), W0
	XOR	W1, [W0], W1
	MOV	#28672, W0
	AND	W1, W0, W1
	MOV	#lo_addr(IPC2bits), W0
	XOR	W1, [W0], W1
	MOV	W1, IPC2bits
;SensorNivel.c,288 :: 		Delay_ms(100);                                                             //Espera hasta que se estabilicen los cambios
	MOV	#21, W8
	MOV	#22619, W7
L_ConfiguracionPrincipal9:
	DEC	W7
	BRA NZ	L_ConfiguracionPrincipal9
	DEC	W8
	BRA NZ	L_ConfiguracionPrincipal9
;SensorNivel.c,290 :: 		}
L_end_ConfiguracionPrincipal:
	POP	W11
	POP	W10
	RETURN
; end of _ConfiguracionPrincipal

_ProcesarSolicitud:
	LNK	#8

;SensorNivel.c,295 :: 		void ProcesarSolicitud(unsigned char *cabeceraSolicitud, unsigned char *payloadSolicitud){
;SensorNivel.c,305 :: 		ptrNumDatosResp = (unsigned char *) & numDatosResp;
	PUSH	W10
	PUSH	W11
	PUSH	W12
	ADD	W14, #2, W0
; ptrNumDatosResp start address is: 18 (W9)
	MOV	W0, W9
;SensorNivel.c,306 :: 		ptrDatoInt = (unsigned char *) & datoInt;
	ADD	W14, #0, W0
; ptrDatoInt start address is: 4 (W2)
	MOV	W0, W2
;SensorNivel.c,307 :: 		ptrDatoFloat = (unsigned char *) & datoFloat;
	ADD	W14, #4, W0
; ptrDatoFloat start address is: 6 (W3)
	MOV	W0, W3
;SensorNivel.c,310 :: 		funcionSolicitud = cabeceraSolicitud[1];
	ADD	W10, #1, W0
; funcionSolicitud start address is: 2 (W1)
	MOV.B	[W0], W1
;SensorNivel.c,311 :: 		subFuncionSolicitud = cabeceraSolicitud[2];
	ADD	W10, #2, W0
; subFuncionSolicitud start address is: 0 (W0)
	MOV.B	[W0], W0
;SensorNivel.c,313 :: 		switch (funcionSolicitud){
	GOTO	L_ProcesarSolicitud11
; ptrNumDatosResp end address is: 18 (W9)
; ptrDatoInt end address is: 4 (W2)
; ptrDatoFloat end address is: 6 (W3)
; funcionSolicitud end address is: 2 (W1)
;SensorNivel.c,314 :: 		case 1:
L_ProcesarSolicitud13:
;SensorNivel.c,315 :: 		switch (subFuncionSolicitud){
	GOTO	L_ProcesarSolicitud14
; subFuncionSolicitud end address is: 0 (W0)
;SensorNivel.c,316 :: 		case 1:
L_ProcesarSolicitud16:
;SensorNivel.c,318 :: 		temperaturaRaw = LeerDS18B20();
	CALL	_LeerDS18B20
	MOV	W0, _temperaturaRaw
;SensorNivel.c,319 :: 		TOF = CalcularTOF();
	CALL	_CalcularTOF
	MOV	W0, _TOF
	MOV	W1, _TOF+2
;SensorNivel.c,320 :: 		break;
	GOTO	L_ProcesarSolicitud15
;SensorNivel.c,321 :: 		case 2:
L_ProcesarSolicitud17:
;SensorNivel.c,323 :: 		temperaturaRaw = LeerDS18B20();
	CALL	_LeerDS18B20
	MOV	W0, _temperaturaRaw
;SensorNivel.c,324 :: 		CapturarMuestras();
	CALL	_CapturarMuestras
;SensorNivel.c,325 :: 		break;
	GOTO	L_ProcesarSolicitud15
;SensorNivel.c,326 :: 		case 3:
L_ProcesarSolicitud18:
;SensorNivel.c,328 :: 		temperaturaRaw = LeerDS18B20();
	CALL	_LeerDS18B20
	MOV	W0, _temperaturaRaw
;SensorNivel.c,329 :: 		ProbarMuestreo();
	CALL	_ProbarMuestreo
;SensorNivel.c,330 :: 		break;
	GOTO	L_ProcesarSolicitud15
;SensorNivel.c,332 :: 		case 4:
L_ProcesarSolicitud19:
;SensorNivel.c,334 :: 		temperaturaRaw = LeerDS18B20();
	CALL	_LeerDS18B20
	MOV	W0, _temperaturaRaw
;SensorNivel.c,335 :: 		ProbarEnvioTrama();
	CALL	_ProbarEnvioTrama
;SensorNivel.c,336 :: 		break;
	GOTO	L_ProcesarSolicitud15
;SensorNivel.c,337 :: 		default:
L_ProcesarSolicitud20:
;SensorNivel.c,339 :: 		temperaturaRaw = LeerDS18B20();
	CALL	_LeerDS18B20
	MOV	W0, _temperaturaRaw
;SensorNivel.c,340 :: 		TOF = CalcularTOF();
	CALL	_CalcularTOF
	MOV	W0, _TOF
	MOV	W1, _TOF+2
;SensorNivel.c,341 :: 		break;
	GOTO	L_ProcesarSolicitud15
;SensorNivel.c,342 :: 		}
L_ProcesarSolicitud14:
; subFuncionSolicitud start address is: 0 (W0)
	CP.B	W0, #1
	BRA NZ	L__ProcesarSolicitud127
	GOTO	L_ProcesarSolicitud16
L__ProcesarSolicitud127:
	CP.B	W0, #2
	BRA NZ	L__ProcesarSolicitud128
	GOTO	L_ProcesarSolicitud17
L__ProcesarSolicitud128:
	CP.B	W0, #3
	BRA NZ	L__ProcesarSolicitud129
	GOTO	L_ProcesarSolicitud18
L__ProcesarSolicitud129:
	CP.B	W0, #4
	BRA NZ	L__ProcesarSolicitud130
	GOTO	L_ProcesarSolicitud19
L__ProcesarSolicitud130:
; subFuncionSolicitud end address is: 0 (W0)
	GOTO	L_ProcesarSolicitud20
L_ProcesarSolicitud15:
;SensorNivel.c,343 :: 		break;
	GOTO	L_ProcesarSolicitud12
;SensorNivel.c,344 :: 		case 2:
L_ProcesarSolicitud21:
;SensorNivel.c,347 :: 		switch (subFuncionSolicitud){
; subFuncionSolicitud start address is: 0 (W0)
; ptrDatoFloat start address is: 6 (W3)
; ptrDatoInt start address is: 4 (W2)
; ptrNumDatosResp start address is: 18 (W9)
	GOTO	L_ProcesarSolicitud22
; subFuncionSolicitud end address is: 0 (W0)
;SensorNivel.c,348 :: 		case 1:
L_ProcesarSolicitud24:
;SensorNivel.c,351 :: 		datoInt = temperaturaRaw;
	MOV	_temperaturaRaw, W0
	MOV	W0, [W14+0]
;SensorNivel.c,352 :: 		datoFloat = TOF;
	MOV	_TOF, W0
	MOV	_TOF+2, W1
	MOV	W0, [W14+4]
	MOV	W1, [W14+6]
;SensorNivel.c,353 :: 		respuestaPyloadRS485[0] = *(ptrDatoFloat);
	MOV.B	[W3], W1
	MOV	#lo_addr(_respuestaPyloadRS485), W0
	MOV.B	W1, [W0]
;SensorNivel.c,354 :: 		respuestaPyloadRS485[1] = *(ptrDatoFloat+1);
	ADD	W3, #1, W0
	MOV.B	[W0], W1
	MOV	#lo_addr(_respuestaPyloadRS485+1), W0
	MOV.B	W1, [W0]
;SensorNivel.c,355 :: 		respuestaPyloadRS485[2] = *(ptrDatoFloat+2);
	ADD	W3, #2, W0
	MOV.B	[W0], W1
	MOV	#lo_addr(_respuestaPyloadRS485+2), W0
	MOV.B	W1, [W0]
;SensorNivel.c,356 :: 		respuestaPyloadRS485[3] = *(ptrDatoFloat+3);
	ADD	W3, #3, W0
; ptrDatoFloat end address is: 6 (W3)
	MOV.B	[W0], W1
	MOV	#lo_addr(_respuestaPyloadRS485+3), W0
	MOV.B	W1, [W0]
;SensorNivel.c,357 :: 		respuestaPyloadRS485[4] = *(ptrDatoInt);
	MOV.B	[W2], W1
	MOV	#lo_addr(_respuestaPyloadRS485+4), W0
	MOV.B	W1, [W0]
;SensorNivel.c,358 :: 		respuestaPyloadRS485[5] = *(ptrDatoInt+1);
	ADD	W2, #1, W0
; ptrDatoInt end address is: 4 (W2)
	MOV.B	[W0], W1
	MOV	#lo_addr(_respuestaPyloadRS485+5), W0
	MOV.B	W1, [W0]
;SensorNivel.c,360 :: 		numDatosResp = 6;
	MOV	#6, W0
	MOV	W0, [W14+2]
;SensorNivel.c,361 :: 		cabeceraSolicitud[3] = *(ptrNumDatosResp);
	ADD	W10, #3, W0
	MOV.B	[W9], [W0]
;SensorNivel.c,362 :: 		cabeceraSolicitud[4] = *(ptrNumDatosResp+1);
	ADD	W10, #4, W1
	ADD	W9, #1, W0
; ptrNumDatosResp end address is: 18 (W9)
	MOV.B	[W0], [W1]
;SensorNivel.c,363 :: 		EnviarTramaRS485(1, cabeceraSolicitud, respuestaPyloadRS485);
	MOV	#lo_addr(_respuestaPyloadRS485), W12
	MOV	W10, W11
	MOV.B	#1, W10
	CALL	_EnviarTramaRS485
;SensorNivel.c,364 :: 		break;
	GOTO	L_ProcesarSolicitud23
;SensorNivel.c,365 :: 		case 2:
L_ProcesarSolicitud25:
;SensorNivel.c,368 :: 		numDatosResp = 702;
; ptrNumDatosResp start address is: 18 (W9)
	MOV	#702, W0
	MOV	W0, [W14+2]
;SensorNivel.c,369 :: 		cabeceraSolicitud[3] = *(ptrNumDatosResp);
	ADD	W10, #3, W0
	MOV.B	[W9], [W0]
;SensorNivel.c,370 :: 		cabeceraSolicitud[4] = *(ptrNumDatosResp+1);
	ADD	W10, #4, W1
	ADD	W9, #1, W0
; ptrNumDatosResp end address is: 18 (W9)
	MOV.B	[W0], [W1]
;SensorNivel.c,371 :: 		EnviarTramaInt(cabeceraSolicitud, temperaturaRaw);
	MOV	_temperaturaRaw, W11
	CALL	_EnviarTramaInt
;SensorNivel.c,372 :: 		break;
	GOTO	L_ProcesarSolicitud23
;SensorNivel.c,373 :: 		}
L_ProcesarSolicitud22:
; subFuncionSolicitud start address is: 0 (W0)
; ptrDatoFloat start address is: 6 (W3)
; ptrDatoInt start address is: 4 (W2)
; ptrNumDatosResp start address is: 18 (W9)
	CP.B	W0, #1
	BRA NZ	L__ProcesarSolicitud131
	GOTO	L_ProcesarSolicitud24
L__ProcesarSolicitud131:
; ptrDatoInt end address is: 4 (W2)
; ptrDatoFloat end address is: 6 (W3)
	CP.B	W0, #2
	BRA NZ	L__ProcesarSolicitud132
	GOTO	L_ProcesarSolicitud25
L__ProcesarSolicitud132:
; ptrNumDatosResp end address is: 18 (W9)
; subFuncionSolicitud end address is: 0 (W0)
L_ProcesarSolicitud23:
;SensorNivel.c,374 :: 		break;
	GOTO	L_ProcesarSolicitud12
;SensorNivel.c,375 :: 		case 3:
L_ProcesarSolicitud26:
;SensorNivel.c,377 :: 		switch (subFuncionSolicitud){
; subFuncionSolicitud start address is: 0 (W0)
	GOTO	L_ProcesarSolicitud27
; subFuncionSolicitud end address is: 0 (W0)
;SensorNivel.c,378 :: 		case 1:
L_ProcesarSolicitud29:
;SensorNivel.c,380 :: 		pulsosDistancia = payloadSolicitud[0];
	MOV.B	[W11], W1
	MOV	#lo_addr(_pulsosDistancia), W0
	MOV.B	W1, [W0]
;SensorNivel.c,381 :: 		LED1 = ~LED1;
	BTG	LATA4_bit, BitPos(LATA4_bit+0)
;SensorNivel.c,382 :: 		Delay_ms(250);
	MOV	#51, W8
	MOV	#56549, W7
L_ProcesarSolicitud30:
	DEC	W7
	BRA NZ	L_ProcesarSolicitud30
	DEC	W8
	BRA NZ	L_ProcesarSolicitud30
;SensorNivel.c,383 :: 		LED1 = ~LED1;
	BTG	LATA4_bit, BitPos(LATA4_bit+0)
;SensorNivel.c,384 :: 		break;
	GOTO	L_ProcesarSolicitud28
;SensorNivel.c,385 :: 		}
L_ProcesarSolicitud27:
; subFuncionSolicitud start address is: 0 (W0)
	CP.B	W0, #1
	BRA NZ	L__ProcesarSolicitud133
	GOTO	L_ProcesarSolicitud29
L__ProcesarSolicitud133:
; subFuncionSolicitud end address is: 0 (W0)
L_ProcesarSolicitud28:
;SensorNivel.c,386 :: 		break;
	GOTO	L_ProcesarSolicitud12
;SensorNivel.c,387 :: 		case 4:
L_ProcesarSolicitud32:
;SensorNivel.c,389 :: 		switch (subFuncionSolicitud){
; subFuncionSolicitud start address is: 0 (W0)
; ptrNumDatosResp start address is: 18 (W9)
	GOTO	L_ProcesarSolicitud33
; subFuncionSolicitud end address is: 0 (W0)
;SensorNivel.c,390 :: 		case 1:
L_ProcesarSolicitud35:
;SensorNivel.c,393 :: 		numDatosResp = 10;
	MOV	#10, W0
	MOV	W0, [W14+2]
;SensorNivel.c,394 :: 		cabeceraSolicitud[3] = *(ptrNumDatosResp);
	ADD	W10, #3, W0
	MOV.B	[W9], [W0]
;SensorNivel.c,395 :: 		cabeceraSolicitud[4] = *(ptrNumDatosResp+1);
	ADD	W10, #4, W1
	ADD	W9, #1, W0
; ptrNumDatosResp end address is: 18 (W9)
	MOV.B	[W0], [W1]
;SensorNivel.c,396 :: 		EnviarTramaRS485(1, cabeceraSolicitud, tramaPruebaRS485);
	MOV	#lo_addr(_tramaPruebaRS485), W12
	MOV	W10, W11
	MOV.B	#1, W10
	CALL	_EnviarTramaRS485
;SensorNivel.c,397 :: 		LED1 = ~LED1;
	BTG	LATA4_bit, BitPos(LATA4_bit+0)
;SensorNivel.c,398 :: 		break;
	GOTO	L_ProcesarSolicitud34
;SensorNivel.c,399 :: 		case 2:
L_ProcesarSolicitud36:
;SensorNivel.c,402 :: 		numDatosResp = 512;
; ptrNumDatosResp start address is: 18 (W9)
	MOV	#512, W0
	MOV	W0, [W14+2]
;SensorNivel.c,403 :: 		cabeceraSolicitud[3] = *(ptrNumDatosResp);
	ADD	W10, #3, W0
	MOV.B	[W9], [W0]
;SensorNivel.c,404 :: 		cabeceraSolicitud[4] = *(ptrNumDatosResp+1);
	ADD	W10, #4, W1
	ADD	W9, #1, W0
; ptrNumDatosResp end address is: 18 (W9)
	MOV.B	[W0], [W1]
;SensorNivel.c,405 :: 		GenerarTramaPrueba(numDatosResp, cabeceraSolicitud);
	MOV	W10, W11
	MOV	[W14+2], W10
	CALL	_GenerarTramaPrueba
;SensorNivel.c,406 :: 		break;
	GOTO	L_ProcesarSolicitud34
;SensorNivel.c,407 :: 		}
L_ProcesarSolicitud33:
; subFuncionSolicitud start address is: 0 (W0)
; ptrNumDatosResp start address is: 18 (W9)
	CP.B	W0, #1
	BRA NZ	L__ProcesarSolicitud134
	GOTO	L_ProcesarSolicitud35
L__ProcesarSolicitud134:
	CP.B	W0, #2
	BRA NZ	L__ProcesarSolicitud135
	GOTO	L_ProcesarSolicitud36
L__ProcesarSolicitud135:
; ptrNumDatosResp end address is: 18 (W9)
; subFuncionSolicitud end address is: 0 (W0)
L_ProcesarSolicitud34:
;SensorNivel.c,408 :: 		break;
	GOTO	L_ProcesarSolicitud12
;SensorNivel.c,409 :: 		}
L_ProcesarSolicitud11:
; subFuncionSolicitud start address is: 0 (W0)
; funcionSolicitud start address is: 2 (W1)
; ptrDatoFloat start address is: 6 (W3)
; ptrDatoInt start address is: 4 (W2)
; ptrNumDatosResp start address is: 18 (W9)
	CP.B	W1, #1
	BRA NZ	L__ProcesarSolicitud136
	GOTO	L_ProcesarSolicitud13
L__ProcesarSolicitud136:
	CP.B	W1, #2
	BRA NZ	L__ProcesarSolicitud137
	GOTO	L_ProcesarSolicitud21
L__ProcesarSolicitud137:
; ptrDatoInt end address is: 4 (W2)
; ptrDatoFloat end address is: 6 (W3)
	CP.B	W1, #3
	BRA NZ	L__ProcesarSolicitud138
	GOTO	L_ProcesarSolicitud26
L__ProcesarSolicitud138:
	CP.B	W1, #4
	BRA NZ	L__ProcesarSolicitud139
	GOTO	L_ProcesarSolicitud32
L__ProcesarSolicitud139:
; ptrNumDatosResp end address is: 18 (W9)
; funcionSolicitud end address is: 2 (W1)
; subFuncionSolicitud end address is: 0 (W0)
L_ProcesarSolicitud12:
;SensorNivel.c,411 :: 		banderaPeticion = 0;
	MOV	#lo_addr(_banderaPeticion), W1
	CLR	W0
	MOV.B	W0, [W1]
;SensorNivel.c,413 :: 		}
L_end_ProcesarSolicitud:
	POP	W12
	POP	W11
	POP	W10
	ULNK
	RETURN
; end of _ProcesarSolicitud

_GenerarTramaPrueba:
	LNK	#516

;SensorNivel.c,418 :: 		void GenerarTramaPrueba(unsigned int numDatosPrueba, unsigned char *cabeceraPrueba){
;SensorNivel.c,420 :: 		unsigned int contadorMuestras = 0;
	PUSH	W12
; contadorMuestras start address is: 4 (W2)
	CLR	W2
;SensorNivel.c,424 :: 		for (j=0;j<numDatosPrueba;j++){
	CLR	W0
	MOV	W0, _j
; contadorMuestras end address is: 4 (W2)
L_GenerarTramaPrueba37:
; contadorMuestras start address is: 4 (W2)
	MOV	#lo_addr(_j), W0
	CP	W10, [W0]
	BRA GTU	L__GenerarTramaPrueba141
	GOTO	L_GenerarTramaPrueba38
L__GenerarTramaPrueba141:
;SensorNivel.c,425 :: 		outputPyloadRS485[j] = contadorMuestras;
	ADD	W14, #0, W1
	MOV	#lo_addr(_j), W0
	ADD	W1, [W0], W0
	MOV.B	W2, [W0]
;SensorNivel.c,426 :: 		contadorMuestras++;
	ADD	W2, #1, W1
	MOV	W1, W2
;SensorNivel.c,427 :: 		if (contadorMuestras>255) {
	MOV	#255, W0
	CP	W1, W0
	BRA GTU	L__GenerarTramaPrueba142
	GOTO	L__GenerarTramaPrueba104
L__GenerarTramaPrueba142:
;SensorNivel.c,428 :: 		contadorMuestras = 0;
	CLR	W2
; contadorMuestras end address is: 4 (W2)
;SensorNivel.c,429 :: 		}
	GOTO	L_GenerarTramaPrueba40
L__GenerarTramaPrueba104:
;SensorNivel.c,427 :: 		if (contadorMuestras>255) {
;SensorNivel.c,429 :: 		}
L_GenerarTramaPrueba40:
;SensorNivel.c,424 :: 		for (j=0;j<numDatosPrueba;j++){
; contadorMuestras start address is: 4 (W2)
	MOV	#1, W1
	MOV	#lo_addr(_j), W0
	ADD	W1, [W0], [W0]
;SensorNivel.c,430 :: 		}
; contadorMuestras end address is: 4 (W2)
	GOTO	L_GenerarTramaPrueba37
L_GenerarTramaPrueba38:
;SensorNivel.c,432 :: 		EnviarTramaRS485(1, cabeceraPrueba, outputPyloadRS485);
	ADD	W14, #0, W0
	PUSH	W10
	MOV	W0, W12
	MOV.B	#1, W10
	CALL	_EnviarTramaRS485
	POP	W10
;SensorNivel.c,434 :: 		}
L_end_GenerarTramaPrueba:
	POP	W12
	ULNK
	RETURN
; end of _GenerarTramaPrueba

_LeerDS18B20:

;SensorNivel.c,439 :: 		unsigned int LeerDS18B20(){
;SensorNivel.c,443 :: 		LED1 = 1;
	PUSH	W10
	PUSH	W11
	PUSH	W12
	BSET	LATA4_bit, BitPos(LATA4_bit+0)
;SensorNivel.c,446 :: 		Ow_Reset(&PORTA, 0);                                                       //Onewire reset signal
	CLR	W11
	MOV	#lo_addr(PORTA), W10
	CALL	_Ow_Reset
;SensorNivel.c,447 :: 		Ow_Write(&PORTA, 0, 0xCC);                                                 //Issue command SKIP_ROM
	MOV.B	#204, W12
	CLR	W11
	MOV	#lo_addr(PORTA), W10
	CALL	_Ow_Write
;SensorNivel.c,448 :: 		Ow_Write(&PORTA, 0, 0x44);                                                 //Issue command CONVERT_T
	MOV.B	#68, W12
	CLR	W11
	MOV	#lo_addr(PORTA), W10
	CALL	_Ow_Write
;SensorNivel.c,449 :: 		Delay_ms(750);
	MOV	#153, W8
	MOV	#38577, W7
L_LeerDS18B2041:
	DEC	W7
	BRA NZ	L_LeerDS18B2041
	DEC	W8
	BRA NZ	L_LeerDS18B2041
	NOP
	NOP
;SensorNivel.c,450 :: 		Ow_Reset(&PORTA, 0);
	CLR	W11
	MOV	#lo_addr(PORTA), W10
	CALL	_Ow_Reset
;SensorNivel.c,451 :: 		Ow_Write(&PORTA, 0, 0xCC);                                                 //Issue command SKIP_ROM
	MOV.B	#204, W12
	CLR	W11
	MOV	#lo_addr(PORTA), W10
	CALL	_Ow_Write
;SensorNivel.c,452 :: 		Ow_Write(&PORTA, 0, 0xBE);                                                 //Issue command READ_SCRATCHPAD
	MOV.B	#190, W12
	CLR	W11
	MOV	#lo_addr(PORTA), W10
	CALL	_Ow_Write
;SensorNivel.c,453 :: 		Delay_us(100);
	MOV	#1333, W7
L_LeerDS18B2043:
	DEC	W7
	BRA NZ	L_LeerDS18B2043
	NOP
;SensorNivel.c,454 :: 		temp = Ow_Read(&PORTA, 0);
	CLR	W11
	MOV	#lo_addr(PORTA), W10
	CALL	_Ow_Read
; temp start address is: 10 (W5)
	ZE	W0, W5
;SensorNivel.c,455 :: 		temp = (Ow_Read(&PORTA, 0) << 8) + temp;
	CLR	W11
	MOV	#lo_addr(PORTA), W10
	CALL	_Ow_Read
	ZE	W0, W0
	SL	W0, #8, W0
	ADD	W0, W5, W0
; temp end address is: 10 (W5)
;SensorNivel.c,457 :: 		LED1 = 0;
	BCLR	LATA4_bit, BitPos(LATA4_bit+0)
;SensorNivel.c,461 :: 		return temperaturaCrudo;
;SensorNivel.c,463 :: 		}
;SensorNivel.c,461 :: 		return temperaturaCrudo;
;SensorNivel.c,463 :: 		}
L_end_LeerDS18B20:
	POP	W12
	POP	W11
	POP	W10
	RETURN
; end of _LeerDS18B20

_ProbarEnvioTrama:

;SensorNivel.c,467 :: 		void ProbarEnvioTrama(){
;SensorNivel.c,469 :: 		LED1 = 1;
	BSET	LATA4_bit, BitPos(LATA4_bit+0)
;SensorNivel.c,471 :: 		i = 0;
	CLR	W0
	MOV	W0, _i
;SensorNivel.c,472 :: 		while (i<numeroMuestras){
L_ProbarEnvioTrama45:
	MOV	_i, W1
	MOV	#350, W0
	CP	W1, W0
	BRA LTU	L__ProbarEnvioTrama145
	GOTO	L_ProbarEnvioTrama46
L__ProbarEnvioTrama145:
;SensorNivel.c,473 :: 		vectorMuestras[j] = 255;                                           //Almacena el valor actual de la conversion del ADC en el vectorMuestras
	MOV	_j, W0
	SL	W0, #1, W1
	MOV	#lo_addr(_vectorMuestras), W0
	ADD	W0, W1, W1
	MOV	#255, W0
	MOV	W0, [W1]
;SensorNivel.c,474 :: 		i++;                                                                    //Aumenta en 1 el subindice del vector de Muestras
	MOV	#1, W1
	MOV	#lo_addr(_i), W0
	ADD	W1, [W0], [W0]
;SensorNivel.c,475 :: 		}
	GOTO	L_ProbarEnvioTrama45
L_ProbarEnvioTrama46:
;SensorNivel.c,477 :: 		LED1 = 0;
	BCLR	LATA4_bit, BitPos(LATA4_bit+0)
;SensorNivel.c,478 :: 		delay_ms(200);
	MOV	#41, W8
	MOV	#45239, W7
L_ProbarEnvioTrama47:
	DEC	W7
	BRA NZ	L_ProbarEnvioTrama47
	DEC	W8
	BRA NZ	L_ProbarEnvioTrama47
;SensorNivel.c,479 :: 		LED1 = 1;
	BSET	LATA4_bit, BitPos(LATA4_bit+0)
;SensorNivel.c,480 :: 		delay_ms(200);
	MOV	#41, W8
	MOV	#45239, W7
L_ProbarEnvioTrama49:
	DEC	W7
	BRA NZ	L_ProbarEnvioTrama49
	DEC	W8
	BRA NZ	L_ProbarEnvioTrama49
;SensorNivel.c,481 :: 		LED1 = 0;
	BCLR	LATA4_bit, BitPos(LATA4_bit+0)
;SensorNivel.c,483 :: 		}
L_end_ProbarEnvioTrama:
	RETURN
; end of _ProbarEnvioTrama

_ProbarMuestreo:

;SensorNivel.c,487 :: 		void ProbarMuestreo(){
;SensorNivel.c,489 :: 		LED1 = 1;
	BSET	LATA4_bit, BitPos(LATA4_bit+0)
;SensorNivel.c,491 :: 		TMR1 = 0;                                                                  //Encera el TMR1
	CLR	TMR1
;SensorNivel.c,492 :: 		T1CON.TON = 1;                                                             //Enciende el TMR1
	BSET	T1CON, #15
;SensorNivel.c,493 :: 		bm = 0;
	MOV	#lo_addr(_bm), W1
	CLR	W0
	MOV.B	W0, [W1]
;SensorNivel.c,494 :: 		i = 0;
	CLR	W0
	MOV	W0, _i
;SensorNivel.c,495 :: 		while(bm!=1);
L_ProbarMuestreo51:
	MOV	#lo_addr(_bm), W0
	MOV.B	[W0], W0
	CP.B	W0, #1
	BRA NZ	L__ProbarMuestreo147
	GOTO	L_ProbarMuestreo52
L__ProbarMuestreo147:
	GOTO	L_ProbarMuestreo51
L_ProbarMuestreo52:
;SensorNivel.c,497 :: 		LED1 = 0;
	BCLR	LATA4_bit, BitPos(LATA4_bit+0)
;SensorNivel.c,499 :: 		}
L_end_ProbarMuestreo:
	RETURN
; end of _ProbarMuestreo

_CapturarMuestras:

;SensorNivel.c,504 :: 		void CapturarMuestras(){
;SensorNivel.c,506 :: 		LED1 = 1;
	BSET	LATA4_bit, BitPos(LATA4_bit+0)
;SensorNivel.c,509 :: 		bm = 0;
	MOV	#lo_addr(_bm), W1
	CLR	W0
	MOV.B	W0, [W1]
;SensorNivel.c,510 :: 		contPulsos = 0;                                                            //Limpia la variable del contador de pulsos
	CLR	W0
	MOV	W0, _contPulsos
;SensorNivel.c,511 :: 		RB2_bit = 0;                                                               //Limpia el pin que produce los pulsos de exitacion del transductor
	BCLR	RB2_bit, BitPos(RB2_bit+0)
;SensorNivel.c,512 :: 		T1CON.TON = 0;                                                             //Apaga el TMR1
	BCLR	T1CON, #15
;SensorNivel.c,513 :: 		TMR2 = 0;                                                                  //Encera el TMR2
	CLR	TMR2
;SensorNivel.c,514 :: 		T2CON.TON = 1;                                                             //Enciende el TMR2
	BSET	T2CON, #15
;SensorNivel.c,515 :: 		i = 0;                                                                     //Limpia las variables asociadas al almacenamiento de la senal muestreada
	CLR	W0
	MOV	W0, _i
;SensorNivel.c,516 :: 		while(bm!=1);
L_CapturarMuestras53:
	MOV	#lo_addr(_bm), W0
	MOV.B	[W0], W0
	CP.B	W0, #1
	BRA NZ	L__CapturarMuestras149
	GOTO	L_CapturarMuestras54
L__CapturarMuestras149:
	GOTO	L_CapturarMuestras53
L_CapturarMuestras54:
;SensorNivel.c,518 :: 		LED1 = 0;
	BCLR	LATA4_bit, BitPos(LATA4_bit+0)
;SensorNivel.c,520 :: 		}
L_end_CapturarMuestras:
	RETURN
; end of _CapturarMuestras

_ProcesarMuestras:
	LNK	#12

;SensorNivel.c,525 :: 		void ProcesarMuestras(){
;SensorNivel.c,527 :: 		LED1 = 1;
	BSET	LATA4_bit, BitPos(LATA4_bit+0)
;SensorNivel.c,530 :: 		bm = 0;
	MOV	#lo_addr(_bm), W1
	CLR	W0
	MOV.B	W0, [W1]
;SensorNivel.c,531 :: 		contPulsos = 0;                                                            //Limpia la variable del contador de pulsos
	CLR	W0
	MOV	W0, _contPulsos
;SensorNivel.c,532 :: 		RB2_bit = 0;                                                               //Limpia el pin que produce los pulsos de exitacion del transductor
	BCLR	RB2_bit, BitPos(RB2_bit+0)
;SensorNivel.c,533 :: 		T1CON.TON = 0;                                                             //Apaga el TMR1
	BCLR	T1CON, #15
;SensorNivel.c,534 :: 		TMR2 = 0;                                                                  //Encera el TMR2
	CLR	TMR2
;SensorNivel.c,535 :: 		T2CON.TON = 1;                                                             //Enciende el TMR2
	BSET	T2CON, #15
;SensorNivel.c,536 :: 		i = 0;                                                                     //Limpia las variables asociadas al almacenamiento de la senal muestreada
	CLR	W0
	MOV	W0, _i
;SensorNivel.c,537 :: 		while(bm!=1);                                                              //Espera hasta que haya terminado de enviar y recibir todas las muestras
L_ProcesarMuestras55:
	MOV	#lo_addr(_bm), W0
	MOV.B	[W0], W0
	CP.B	W0, #1
	BRA NZ	L__ProcesarMuestras151
	GOTO	L_ProcesarMuestras56
L__ProcesarMuestras151:
	GOTO	L_ProcesarMuestras55
L_ProcesarMuestras56:
;SensorNivel.c,540 :: 		if (bm==1){
	MOV	#lo_addr(_bm), W0
	MOV.B	[W0], W0
	CP.B	W0, #1
	BRA Z	L__ProcesarMuestras152
	GOTO	L_ProcesarMuestras57
L__ProcesarMuestras152:
;SensorNivel.c,543 :: 		Mmed = 508;                                                           //Medido con el osciloscopio: Vmean = 1.64V => 508.4adc
	MOV	#508, W0
	MOV	W0, _Mmed
;SensorNivel.c,545 :: 		for (k=0;k<numeroMuestras;k++){
	CLR	W0
	MOV	W0, _k
L_ProcesarMuestras58:
	MOV	_k, W1
	MOV	#350, W0
	CP	W1, W0
	BRA LTU	L__ProcesarMuestras153
	GOTO	L_ProcesarMuestras59
L__ProcesarMuestras153:
;SensorNivel.c,548 :: 		valorAbsoluto = vectorMuestras[k]-Mmed;
	MOV	_k, W0
	SL	W0, #1, W1
	MOV	#lo_addr(_vectorMuestras), W0
	ADD	W0, W1, W3
	MOV	[W3], W2
	MOV	#lo_addr(_Mmed), W1
	MOV	#lo_addr(_valorAbsoluto), W0
	SUB	W2, [W1], [W0]
;SensorNivel.c,549 :: 		if (vectorMuestras[k]<Mmed){
	MOV	[W3], W1
	MOV	#lo_addr(_Mmed), W0
	CP	W1, [W0]
	BRA LTU	L__ProcesarMuestras154
	GOTO	L_ProcesarMuestras61
L__ProcesarMuestras154:
;SensorNivel.c,550 :: 		valorAbsoluto = (vectorMuestras[k]+((Mmed-vectorMuestras[k])*2))-(Mmed);
	MOV	_k, W0
	SL	W0, #1, W1
	MOV	#lo_addr(_vectorMuestras), W0
	ADD	W0, W1, W1
	MOV	_Mmed, W0
	SUB	W0, [W1], W0
	SL	W0, #1, W0
	ADD	W0, [W1], W2
	MOV	#lo_addr(_Mmed), W1
	MOV	#lo_addr(_valorAbsoluto), W0
	SUB	W2, [W1], [W0]
;SensorNivel.c,551 :: 		}
L_ProcesarMuestras61:
;SensorNivel.c,555 :: 		for( f=O-1; f!=0; f-- ) XFIR[f]=XFIR[f-1];
	MOV	#20, W0
	MOV	W0, _f
L_ProcesarMuestras62:
	MOV	_f, W0
	CP	W0, #0
	BRA NZ	L__ProcesarMuestras155
	GOTO	L_ProcesarMuestras63
L__ProcesarMuestras155:
	MOV	_f, W0
	SL	W0, #2, W1
	MOV	#lo_addr(_XFIR), W0
	ADD	W0, W1, W2
	MOV	_f, W0
	DEC	W0
	SL	W0, #2, W1
	MOV	#lo_addr(_XFIR), W0
	ADD	W0, W1, W0
	MOV	[W0++], [W2++]
	MOV	[W0--], [W2--]
	MOV	#1, W1
	MOV	#lo_addr(_f), W0
	SUBR	W1, [W0], [W0]
	GOTO	L_ProcesarMuestras62
L_ProcesarMuestras63:
;SensorNivel.c,557 :: 		XFIR[0] = (float)(valorAbsoluto);
	MOV	_valorAbsoluto, W0
	CLR	W1
	CALL	__Long2Float
	MOV	W0, _XFIR
	MOV	W1, _XFIR+2
;SensorNivel.c,559 :: 		y0 = 0.0; for( f=0; f<O; f++ ) y0 += h[f]*XFIR[f];
	CLR	W0
	CLR	W1
	MOV	W0, _y0
	MOV	W1, _y0+2
	CLR	W0
	MOV	W0, _f
L_ProcesarMuestras65:
	MOV	_f, W0
	CP	W0, #21
	BRA LTU	L__ProcesarMuestras156
	GOTO	L_ProcesarMuestras66
L__ProcesarMuestras156:
	MOV	_f, W0
	SL	W0, #2, W2
	MOV	#lo_addr(_h), W0
	ADD	W0, W2, W1
	MOV	#___Lib_System_DefaultPage, W0
	MOV	WREG, 52
	MOV	[W1++], W3
	MOV	[W1--], W4
	MOV	#lo_addr(_XFIR), W0
	ADD	W0, W2, W2
	MOV.D	[W2], W0
	MOV	W3, W2
	MOV	W4, W3
	CALL	__Mul_FP
	MOV	_y0, W2
	MOV	_y0+2, W3
	CALL	__AddSub_FP
	MOV	W0, _y0
	MOV	W1, _y0+2
	MOV	#1, W1
	MOV	#lo_addr(_f), W0
	ADD	W1, [W0], [W0]
	GOTO	L_ProcesarMuestras65
L_ProcesarMuestras66:
;SensorNivel.c,561 :: 		YY = (unsigned int)(y0);                                          //Reconstruccion de la senal: y en 10 bits.
	MOV	_y0, W0
	MOV	_y0+2, W1
	CALL	__Float2Longint
	MOV	W0, _YY
;SensorNivel.c,562 :: 		vectorMuestras[k] = YY;
	MOV	_k, W1
	SL	W1, #1, W2
	MOV	#lo_addr(_vectorMuestras), W1
	ADD	W1, W2, W1
	MOV	W0, [W1]
;SensorNivel.c,545 :: 		for (k=0;k<numeroMuestras;k++){
	MOV	#1, W1
	MOV	#lo_addr(_k), W0
	ADD	W1, [W0], [W0]
;SensorNivel.c,564 :: 		}
	GOTO	L_ProcesarMuestras58
L_ProcesarMuestras59:
;SensorNivel.c,566 :: 		bm = 2;                                                               //Cambia el estado de la bandera bm para dar paso al calculo del pmax y TOF
	MOV	#lo_addr(_bm), W1
	MOV.B	#2, W0
	MOV.B	W0, [W1]
;SensorNivel.c,568 :: 		}
L_ProcesarMuestras57:
;SensorNivel.c,571 :: 		if (bm==2){
	MOV	#lo_addr(_bm), W0
	MOV.B	[W0], W0
	CP.B	W0, #2
	BRA Z	L__ProcesarMuestras157
	GOTO	L_ProcesarMuestras68
L__ProcesarMuestras157:
;SensorNivel.c,573 :: 		yy1 = Vector_Max(vectorMuestras, numeroMuestras, &maxIndex);                                    //Encuentra el valor maximo del vector R
	MOV	#lo_addr(_maxIndex), W0
	PUSH	W0
	MOV	#350, W0
	PUSH	W0
	MOV	#lo_addr(_vectorMuestras), W0
	PUSH	W0
	CALL	_Vector_Max
	SUB	#6, W15
	MOV	W0, _yy1
;SensorNivel.c,574 :: 		i1b = maxIndex;                                                        //Asigna el subindice del valor maximo a la variable i1a
	MOV	_maxIndex, W0
	MOV	W0, _i1b
;SensorNivel.c,575 :: 		i1a = 0;
	CLR	W0
	MOV	W0, _i1a
;SensorNivel.c,577 :: 		while (vectorMuestras[i1a]<yy1){
L_ProcesarMuestras69:
	MOV	_i1a, W0
	SL	W0, #1, W1
	MOV	#lo_addr(_vectorMuestras), W0
	ADD	W0, W1, W0
	MOV	[W0], W1
	MOV	#lo_addr(_yy1), W0
	CP	W1, [W0]
	BRA LTU	L__ProcesarMuestras158
	GOTO	L_ProcesarMuestras70
L__ProcesarMuestras158:
;SensorNivel.c,578 :: 		i1a++;
	MOV	#1, W1
	MOV	#lo_addr(_i1a), W0
	ADD	W1, [W0], [W0]
;SensorNivel.c,579 :: 		}
	GOTO	L_ProcesarMuestras69
L_ProcesarMuestras70:
;SensorNivel.c,581 :: 		i1 = i1a+((i1b-i1a)/2);
	MOV	_i1b, W1
	MOV	#lo_addr(_i1a), W0
	SUB	W1, [W0], W0
	LSR	W0, #1, W1
	MOV	#lo_addr(_i1a), W0
	ADD	W1, [W0], W1
	MOV	W1, _i1
;SensorNivel.c,582 :: 		i0 = i1 - dix;
	SUB	W1, #20, W0
	MOV	W0, _i0
;SensorNivel.c,583 :: 		i2 = i1 + dix;
	ADD	W1, #20, W3
	MOV	W3, _i2
;SensorNivel.c,585 :: 		yy0 = vectorMuestras[i0];
	SL	W0, #1, W1
	MOV	#lo_addr(_vectorMuestras), W0
	ADD	W0, W1, W0
	MOV	[W0], W2
	MOV	W2, _yy0
;SensorNivel.c,586 :: 		yy2 = vectorMuestras[i2];
	SL	W3, #1, W1
	MOV	#lo_addr(_vectorMuestras), W0
	ADD	W0, W1, W0
	MOV	[W0], W0
	MOV	W0, [W14+0]
	MOV	W0, _yy2
;SensorNivel.c,588 :: 		yf0 = (float)(yy0);
	MOV	W2, W0
	ASR	W0, #15, W1
	SETM	W2
	CALL	__Long2Float
	MOV	W0, [W14+8]
	MOV	W1, [W14+10]
	MOV	W0, _yf0
	MOV	W1, _yf0+2
;SensorNivel.c,589 :: 		yf1 = (float)(yy1);
	MOV	_yy1, W0
	ASR	W0, #15, W1
	SETM	W2
	CALL	__Long2Float
	MOV	W0, [W14+4]
	MOV	W1, [W14+6]
	MOV	W0, _yf1
	MOV	W1, _yf1+2
;SensorNivel.c,590 :: 		yf2 = (float)(yy2);
	MOV	[W14+0], W0
	ASR	W0, #15, W1
	SETM	W2
	CALL	__Long2Float
	MOV	W0, [W14+0]
	MOV	W1, [W14+2]
	PUSH.D	W0
	MOV	[W14+0], W0
	MOV	[W14+2], W1
	MOV	W0, _yf2
	MOV	W1, _yf2+2
	POP.D	W0
;SensorNivel.c,592 :: 		nx = (yf0-yf2)/(2.0*(yf0-(2.0*yf1)+yf2));                              //Factor de ajuste determinado por interpolacion parabolica
	MOV	[W14+8], W0
	MOV	[W14+10], W1
	PUSH.D	W2
	MOV	[W14+0], W2
	MOV	[W14+2], W3
	CALL	__Sub_FP
	POP.D	W2
	MOV	[W14+4], W2
	MOV	[W14+6], W3
	MOV	W0, [W14+4]
	MOV	W1, [W14+6]
	MOV	#0, W0
	MOV	#16384, W1
	CALL	__Mul_FP
	MOV	W0, [W14+0]
	MOV	W1, [W14+2]
	MOV	_yf0, W0
	MOV	_yf0+2, W1
	PUSH.D	W2
	MOV	[W14+0], W2
	MOV	[W14+2], W3
	CALL	__Sub_FP
	POP.D	W2
	MOV	_yf2, W2
	MOV	_yf2+2, W3
	CALL	__AddSub_FP
	MOV	#0, W2
	MOV	#16384, W3
	CALL	__Mul_FP
	MOV	W0, [W14+0]
	MOV	W1, [W14+2]
	MOV	[W14+4], W0
	MOV	[W14+6], W1
	PUSH.D	W2
	MOV	[W14+0], W2
	MOV	[W14+2], W3
	CALL	__Div_FP
	POP.D	W2
	MOV	W0, _nx
	MOV	W1, _nx+2
;SensorNivel.c,593 :: 		dx = nx*dix*tx;
	MOV	#0, W2
	MOV	#16800, W3
	CALL	__Mul_FP
	MOV	#0, W2
	MOV	#16544, W3
	CALL	__Mul_FP
	MOV	W0, _dx
	MOV	W1, _dx+2
;SensorNivel.c,594 :: 		tmax = i1*tx;
	MOV	_i1, W0
	CLR	W1
	CALL	__Long2Float
	MOV	#0, W2
	MOV	#16544, W3
	CALL	__Mul_FP
	MOV	W0, _tmax
	MOV	W1, _tmax+2
;SensorNivel.c,596 :: 		T2 = tmax+dx;
	MOV	_dx, W2
	MOV	_dx+2, W3
	CALL	__AddSub_FP
	MOV	W0, _T2
	MOV	W1, _T2+2
;SensorNivel.c,598 :: 		}
L_ProcesarMuestras68:
;SensorNivel.c,600 :: 		LED1 = 0;
	BCLR	LATA4_bit, BitPos(LATA4_bit+0)
;SensorNivel.c,602 :: 		}
L_end_ProcesarMuestras:
	ULNK
	RETURN
; end of _ProcesarMuestras

_CalcularTOF:

;SensorNivel.c,606 :: 		float CalcularTOF(){
;SensorNivel.c,608 :: 		conts = 0;                                                                 //Limpia el contador de secuencias
	MOV	#lo_addr(_conts), W1
	CLR	W0
	MOV.B	W0, [W1]
;SensorNivel.c,609 :: 		T2sum = 0.0;
	CLR	W0
	CLR	W1
	MOV	W0, _T2sum
	MOV	W1, _T2sum+2
;SensorNivel.c,610 :: 		T2prom = 0.0;
	CLR	W0
	CLR	W1
	MOV	W0, _T2prom
	MOV	W1, _T2prom+2
;SensorNivel.c,611 :: 		T2a = 0.0;
	CLR	W0
	CLR	W1
	MOV	W0, _T2a
	MOV	W1, _T2a+2
;SensorNivel.c,612 :: 		T2b = 0.0;
	CLR	W0
	CLR	W1
	MOV	W0, _T2b
	MOV	W1, _T2b+2
;SensorNivel.c,614 :: 		while (conts<Nsm){
L_CalcularTOF71:
	MOV	#lo_addr(_conts), W0
	MOV.B	[W0], W0
	CP.B	W0, #30
	BRA LTU	L__CalcularTOF160
	GOTO	L_CalcularTOF72
L__CalcularTOF160:
;SensorNivel.c,615 :: 		ProcesarMuestras();                                                      //Inicia una secuencia de medicion
	CALL	_ProcesarMuestras
;SensorNivel.c,616 :: 		T2b = T2;
	MOV	_T2, W0
	MOV	_T2+2, W1
	MOV	W0, _T2b
	MOV	W1, _T2b+2
;SensorNivel.c,617 :: 		if ((T2b-T2a)<=T2umb){                                               //Verifica si el T2 actual esta dentro de un umbral pre-establecido
	MOV	_T2, W0
	MOV	_T2+2, W1
	MOV	_T2a, W2
	MOV	_T2a+2, W3
	CALL	__Sub_FP
	MOV	#0, W2
	MOV	#16448, W3
	CALL	__Compare_Le_Fp
	CP0	W0
	CLR.B	W0
	BRA GT	L__CalcularTOF161
	INC.B	W0
L__CalcularTOF161:
	CP0.B	W0
	BRA NZ	L__CalcularTOF162
	GOTO	L_CalcularTOF73
L__CalcularTOF162:
;SensorNivel.c,618 :: 		T2sum = T2sum + T2b;                                              //Acumula la sumatoria de valores de T2 calculados por la funcion ProcesarMuestras()
	MOV	_T2sum, W2
	MOV	_T2sum+2, W3
	MOV	_T2b, W0
	MOV	_T2b+2, W1
	CALL	__AddSub_FP
	MOV	W0, _T2sum
	MOV	W1, _T2sum+2
;SensorNivel.c,619 :: 		conts++;                                                          //Aumenta el contador de secuencias
	MOV.B	#1, W1
	MOV	#lo_addr(_conts), W0
	ADD.B	W1, [W0], [W0]
;SensorNivel.c,620 :: 		}
L_CalcularTOF73:
;SensorNivel.c,621 :: 		T2a = T2b;
	MOV	_T2b, W0
	MOV	_T2b+2, W1
	MOV	W0, _T2a
	MOV	W1, _T2a+2
;SensorNivel.c,622 :: 		}
	GOTO	L_CalcularTOF71
L_CalcularTOF72:
;SensorNivel.c,624 :: 		T2prom = T2sum/Nsm;
	MOV	#0, W2
	MOV	#16880, W3
	MOV	_T2sum, W0
	MOV	_T2sum+2, W1
	CALL	__Div_FP
	MOV	W0, _T2prom
	MOV	W1, _T2prom+2
;SensorNivel.c,626 :: 		return T2prom;
;SensorNivel.c,628 :: 		}
L_end_CalcularTOF:
	RETURN
; end of _CalcularTOF

_EnviarTramaInt:
	LNK	#708

;SensorNivel.c,633 :: 		void EnviarTramaInt(unsigned char* cabecera, unsigned int temperatura){
;SensorNivel.c,641 :: 		ptrValorInt = (unsigned char *) & valorInt;
	PUSH	W12
	MOV	#706, W0
	ADD	W14, W0, W0
; ptrValorInt start address is: 8 (W4)
	MOV	W0, W4
;SensorNivel.c,642 :: 		ptrTemperatura = (unsigned char *) & temperatura;
	MOV	#lo_addr(W11), W0
; ptrTemperatura start address is: 6 (W3)
	MOV	W0, W3
;SensorNivel.c,645 :: 		for (j=0;j<numeroMuestras;j++){
	CLR	W0
	MOV	W0, _j
; ptrTemperatura end address is: 6 (W3)
L_EnviarTramaInt74:
; ptrTemperatura start address is: 6 (W3)
; ptrValorInt start address is: 8 (W4)
; ptrValorInt end address is: 8 (W4)
	MOV	_j, W1
	MOV	#350, W0
	CP	W1, W0
	BRA LTU	L__EnviarTramaInt164
	GOTO	L_EnviarTramaInt75
L__EnviarTramaInt164:
; ptrValorInt end address is: 8 (W4)
;SensorNivel.c,646 :: 		valorInt = vectorMuestras[j];
; ptrValorInt start address is: 8 (W4)
	MOV	_j, W0
	SL	W0, #1, W2
	MOV	#lo_addr(_vectorMuestras), W0
	ADD	W0, W2, W0
	MOV	[W0], W0
	MOV	W0, [W14+706]
;SensorNivel.c,647 :: 		tramaShort[j*2] = *(ptrValorInt);
	ADD	W14, #0, W1
	ADD	W1, W2, W0
	MOV.B	[W4], [W0]
;SensorNivel.c,648 :: 		tramaShort[(j*2)+1] = *(ptrValorInt+1);
	MOV	_j, W0
	SL	W0, #1, W0
	INC	W0
	ADD	W1, W0, W1
	ADD	W4, #1, W0
	MOV.B	[W0], [W1]
;SensorNivel.c,645 :: 		for (j=0;j<numeroMuestras;j++){
	MOV	#1, W1
	MOV	#lo_addr(_j), W0
	ADD	W1, [W0], [W0]
;SensorNivel.c,649 :: 		}
; ptrValorInt end address is: 8 (W4)
	GOTO	L_EnviarTramaInt74
L_EnviarTramaInt75:
;SensorNivel.c,652 :: 		tramaShort[700] = *(ptrTemperatura);
	ADD	W14, #0, W2
	MOV	#700, W0
	ADD	W2, W0, W0
	MOV.B	[W3], [W0]
;SensorNivel.c,653 :: 		tramaShort[701] = *(ptrTemperatura+1);
	MOV	#701, W0
	ADD	W2, W0, W1
	ADD	W3, #1, W0
; ptrTemperatura end address is: 6 (W3)
	MOV.B	[W0], [W1]
;SensorNivel.c,656 :: 		EnviarTramaRS485(1, cabecera, tramaShort);
	PUSH.D	W10
	MOV	W2, W12
	MOV	W10, W11
	MOV.B	#1, W10
	CALL	_EnviarTramaRS485
	POP.D	W10
;SensorNivel.c,658 :: 		}
L_end_EnviarTramaInt:
	POP	W12
	ULNK
	RETURN
; end of _EnviarTramaInt

_Timer1Interrupt:
	PUSH	52
	PUSH	RCOUNT
	PUSH	W0
	MOV	#2, W0
	REPEAT	#12
	PUSH	[W0++]

;SensorNivel.c,666 :: 		void Timer1Interrupt() iv IVT_ADDR_T1INTERRUPT{
;SensorNivel.c,667 :: 		SAMP_bit = 0;                                                              //Limpia el bit SAMP para iniciar la conversion del ADC
	BCLR	SAMP_bit, BitPos(SAMP_bit+0)
;SensorNivel.c,668 :: 		while (!AD1CON1bits.DONE);                                                 //Espera hasta que se complete la conversion
L_Timer1Interrupt77:
	BTSC	AD1CON1bits, #0
	GOTO	L_Timer1Interrupt78
	GOTO	L_Timer1Interrupt77
L_Timer1Interrupt78:
;SensorNivel.c,669 :: 		if (i<numeroMuestras){
	MOV	_i, W1
	MOV	#350, W0
	CP	W1, W0
	BRA LTU	L__Timer1Interrupt166
	GOTO	L_Timer1Interrupt79
L__Timer1Interrupt166:
;SensorNivel.c,670 :: 		vectorMuestras[i] = ADC1BUF0;                                           //Almacena el valor actual de la conversion del ADC en el vectorMuestras
	MOV	_i, W0
	SL	W0, #1, W1
	MOV	#lo_addr(_vectorMuestras), W0
	ADD	W0, W1, W1
	MOV	ADC1BUF0, WREG
	MOV	W0, [W1]
;SensorNivel.c,672 :: 		i++;                                                                    //Aumenta en 1 el subindice del vector de Muestras
	MOV	#1, W1
	MOV	#lo_addr(_i), W0
	ADD	W1, [W0], [W0]
;SensorNivel.c,673 :: 		} else {
	GOTO	L_Timer1Interrupt80
L_Timer1Interrupt79:
;SensorNivel.c,674 :: 		bm = 1;                                                                 //Cambia el valor de la bandera bm para terminar con el muestreo y dar comienzo al procesamiento de la senal
	MOV	#lo_addr(_bm), W1
	MOV.B	#1, W0
	MOV.B	W0, [W1]
;SensorNivel.c,675 :: 		T1CON.TON = 0;                                                          //Apaga el TMR1
	BCLR	T1CON, #15
;SensorNivel.c,676 :: 		}
L_Timer1Interrupt80:
;SensorNivel.c,677 :: 		T1IF_bit = 0;                                                              //Limpia la bandera de interrupcion por desbordamiento del TMR1
	BCLR	T1IF_bit, BitPos(T1IF_bit+0)
;SensorNivel.c,678 :: 		}
L_end_Timer1Interrupt:
	MOV	#26, W0
	REPEAT	#12
	POP	[W0--]
	POP	W0
	POP	RCOUNT
	POP	52
	RETFIE
; end of _Timer1Interrupt

_Timer2Interrupt:
	PUSH	52
	PUSH	RCOUNT
	PUSH	W0
	MOV	#2, W0
	REPEAT	#12
	PUSH	[W0++]

;SensorNivel.c,681 :: 		void Timer2Interrupt() iv IVT_ADDR_T2INTERRUPT{
;SensorNivel.c,683 :: 		if (contPulsos<10){                                                        //Controla el numero total de pulsos de exitacion del transductor ultrasonico. (
	MOV	_contPulsos, W0
	CP	W0, #10
	BRA LTU	L__Timer2Interrupt168
	GOTO	L_Timer2Interrupt81
L__Timer2Interrupt168:
;SensorNivel.c,684 :: 		RB2_bit = ~RB2_bit;                                                   //Conmuta el valor del pin RB14
	BTG	RB2_bit, BitPos(RB2_bit+0)
;SensorNivel.c,685 :: 		}else {
	GOTO	L_Timer2Interrupt82
L_Timer2Interrupt81:
;SensorNivel.c,686 :: 		RB2_bit = 0;                                                          //Pone a cero despues de enviar todos los pulsos de exitacion.
	BCLR	RB2_bit, BitPos(RB2_bit+0)
;SensorNivel.c,688 :: 		if (contPulsos==pulsosDistancia){
	MOV	#lo_addr(_pulsosDistancia), W0
	ZE	[W0], W1
	MOV	#lo_addr(_contPulsos), W0
	CP	W1, [W0]
	BRA Z	L__Timer2Interrupt169
	GOTO	L_Timer2Interrupt83
L__Timer2Interrupt169:
;SensorNivel.c,689 :: 		T2CON.TON = 0;                                                    //Apaga el TMR2
	BCLR	T2CON, #15
;SensorNivel.c,690 :: 		TMR1 = 0;                                                         //Encera el TMR1
	CLR	TMR1
;SensorNivel.c,691 :: 		T1CON.TON = 1;                                                    //Enciende el TMR1
	BSET	T1CON, #15
;SensorNivel.c,692 :: 		bm = 0;
	MOV	#lo_addr(_bm), W1
	CLR	W0
	MOV.B	W0, [W1]
;SensorNivel.c,693 :: 		i = 0;
	CLR	W0
	MOV	W0, _i
;SensorNivel.c,694 :: 		}
L_Timer2Interrupt83:
;SensorNivel.c,695 :: 		}
L_Timer2Interrupt82:
;SensorNivel.c,696 :: 		contPulsos++;                                                              //Aumenta el contador en una unidad.
	MOV	#1, W1
	MOV	#lo_addr(_contPulsos), W0
	ADD	W1, [W0], [W0]
;SensorNivel.c,697 :: 		T2IF_bit = 0;                                                              //Limpia la bandera de interrupcion por desbordamiento del TMR2
	BCLR	T2IF_bit, BitPos(T2IF_bit+0)
;SensorNivel.c,699 :: 		}
L_end_Timer2Interrupt:
	MOV	#26, W0
	REPEAT	#12
	POP	[W0--]
	POP	W0
	POP	RCOUNT
	POP	52
	RETFIE
; end of _Timer2Interrupt

_UART1Interrupt:
	PUSH	52
	PUSH	RCOUNT
	PUSH	W0
	MOV	#2, W0
	REPEAT	#12
	PUSH	[W0++]

;SensorNivel.c,726 :: 		void UART1Interrupt() iv IVT_ADDR_U1RXINTERRUPT {
;SensorNivel.c,728 :: 		U1RXIF_bit = 0;                                                            //Limpia la bandera de interrupcion de UARTRX
	BCLR	U1RXIF_bit, BitPos(U1RXIF_bit+0)
;SensorNivel.c,731 :: 		byteRS485 = UART1_Read();                                               //Lee el byte recibido
	CALL	_UART1_Read
	MOV	#lo_addr(_byteRS485), W1
	MOV.B	W0, [W1]
;SensorNivel.c,735 :: 		if (banRSI==2){
	MOV	#lo_addr(_banRSI), W0
	MOV.B	[W0], W0
	CP.B	W0, #2
	BRA Z	L__UART1Interrupt171
	GOTO	L_UART1Interrupt84
L__UART1Interrupt171:
;SensorNivel.c,737 :: 		if (i_rs485<(numDatosRS485)){
	MOV	_i_rs485, W1
	MOV	#lo_addr(_numDatosRS485), W0
	CP	W1, [W0]
	BRA LTU	L__UART1Interrupt172
	GOTO	L_UART1Interrupt85
L__UART1Interrupt172:
;SensorNivel.c,738 :: 		solicitudPyloadRS485[i_rs485] = byteRS485;
	MOV	#lo_addr(_solicitudPyloadRS485), W1
	MOV	#lo_addr(_i_rs485), W0
	ADD	W1, [W0], W1
	MOV	#lo_addr(_byteRS485), W0
	MOV.B	[W0], [W1]
;SensorNivel.c,739 :: 		i_rs485++;
	MOV	#1, W1
	MOV	#lo_addr(_i_rs485), W0
	ADD	W1, [W0], [W0]
;SensorNivel.c,740 :: 		} else {
	GOTO	L_UART1Interrupt86
L_UART1Interrupt85:
;SensorNivel.c,741 :: 		banRSI = 0;                                                      //Limpia la bandera de inicio de trama
	MOV	#lo_addr(_banRSI), W1
	CLR	W0
	MOV.B	W0, [W1]
;SensorNivel.c,742 :: 		banRSC = 1;                                                      //Activa la bandera de trama completa
	MOV	#lo_addr(_banRSC), W1
	MOV.B	#1, W0
	MOV.B	W0, [W1]
;SensorNivel.c,743 :: 		}
L_UART1Interrupt86:
;SensorNivel.c,744 :: 		}
L_UART1Interrupt84:
;SensorNivel.c,747 :: 		if ((banRSI==0)&&(banRSC==0)){
	MOV	#lo_addr(_banRSI), W0
	MOV.B	[W0], W0
	CP.B	W0, #0
	BRA Z	L__UART1Interrupt173
	GOTO	L__UART1Interrupt110
L__UART1Interrupt173:
	MOV	#lo_addr(_banRSC), W0
	MOV.B	[W0], W0
	CP.B	W0, #0
	BRA Z	L__UART1Interrupt174
	GOTO	L__UART1Interrupt109
L__UART1Interrupt174:
L__UART1Interrupt108:
;SensorNivel.c,748 :: 		if (byteRS485==0x3A){                                                 //Verifica si el primer byte recibido sea el byte de inicio de trama
	MOV	#lo_addr(_byteRS485), W0
	MOV.B	[W0], W1
	MOV.B	#58, W0
	CP.B	W1, W0
	BRA Z	L__UART1Interrupt175
	GOTO	L_UART1Interrupt90
L__UART1Interrupt175:
;SensorNivel.c,749 :: 		banRSI = 1;
	MOV	#lo_addr(_banRSI), W1
	MOV.B	#1, W0
	MOV.B	W0, [W1]
;SensorNivel.c,750 :: 		i_rs485 = 0;
	CLR	W0
	MOV	W0, _i_rs485
;SensorNivel.c,751 :: 		}
L_UART1Interrupt90:
;SensorNivel.c,747 :: 		if ((banRSI==0)&&(banRSC==0)){
L__UART1Interrupt110:
L__UART1Interrupt109:
;SensorNivel.c,753 :: 		if ((banRSI==1)&&(byteRS485!=0x3A)&&(i_rs485<5)){
	MOV	#lo_addr(_banRSI), W0
	MOV.B	[W0], W0
	CP.B	W0, #1
	BRA Z	L__UART1Interrupt176
	GOTO	L__UART1Interrupt113
L__UART1Interrupt176:
	MOV	#lo_addr(_byteRS485), W0
	MOV.B	[W0], W1
	MOV.B	#58, W0
	CP.B	W1, W0
	BRA NZ	L__UART1Interrupt177
	GOTO	L__UART1Interrupt112
L__UART1Interrupt177:
	MOV	_i_rs485, W0
	CP	W0, #5
	BRA LTU	L__UART1Interrupt178
	GOTO	L__UART1Interrupt111
L__UART1Interrupt178:
L__UART1Interrupt107:
;SensorNivel.c,755 :: 		solicitudCabeceraRS485[i_rs485] = byteRS485;                          //Recupera los datos de cabecera de la trama UART: [Direccion, Funcion, Subfuncion, NumeroDatos]
	MOV	#lo_addr(_solicitudCabeceraRS485), W1
	MOV	#lo_addr(_i_rs485), W0
	ADD	W1, [W0], W1
	MOV	#lo_addr(_byteRS485), W0
	MOV.B	[W0], [W1]
;SensorNivel.c,756 :: 		i_rs485++;
	MOV	#1, W1
	MOV	#lo_addr(_i_rs485), W0
	ADD	W1, [W0], [W0]
;SensorNivel.c,753 :: 		if ((banRSI==1)&&(byteRS485!=0x3A)&&(i_rs485<5)){
L__UART1Interrupt113:
L__UART1Interrupt112:
L__UART1Interrupt111:
;SensorNivel.c,758 :: 		if ((banRSI==1)&&(i_rs485==5)){
	MOV	#lo_addr(_banRSI), W0
	MOV.B	[W0], W0
	CP.B	W0, #1
	BRA Z	L__UART1Interrupt179
	GOTO	L__UART1Interrupt117
L__UART1Interrupt179:
	MOV	_i_rs485, W0
	CP	W0, #5
	BRA Z	L__UART1Interrupt180
	GOTO	L__UART1Interrupt116
L__UART1Interrupt180:
L__UART1Interrupt106:
;SensorNivel.c,760 :: 		if ((solicitudCabeceraRS485[0]==IDNODO)||(solicitudCabeceraRS485[0]==255)){
	MOV	#lo_addr(_solicitudCabeceraRS485), W0
	MOV.B	[W0], W0
	CP.B	W0, #2
	BRA NZ	L__UART1Interrupt181
	GOTO	L__UART1Interrupt115
L__UART1Interrupt181:
	MOV	#lo_addr(_solicitudCabeceraRS485), W0
	MOV.B	[W0], W1
	MOV.B	#255, W0
	CP.B	W1, W0
	BRA NZ	L__UART1Interrupt182
	GOTO	L__UART1Interrupt114
L__UART1Interrupt182:
	GOTO	L_UART1Interrupt99
L__UART1Interrupt115:
L__UART1Interrupt114:
;SensorNivel.c,762 :: 		*(ptrNumDatosRS485) = solicitudCabeceraRS485[3];
	MOV	#lo_addr(_solicitudCabeceraRS485+3), W1
	MOV	_ptrNumDatosRS485, W0
	MOV.B	[W1], [W0]
;SensorNivel.c,763 :: 		*(ptrNumDatosRS485+1) = solicitudCabeceraRS485[4];
	MOV	_ptrNumDatosRS485, W0
	ADD	W0, #1, W1
	MOV	#lo_addr(_solicitudCabeceraRS485+4), W0
	MOV.B	[W0], [W1]
;SensorNivel.c,764 :: 		i_rs485 = 0;                                                     //Encera el subindice para almacenar el payload
	CLR	W0
	MOV	W0, _i_rs485
;SensorNivel.c,765 :: 		banRSI = 2;                                                      //Cambia el valor de la bandera para salir del bucle
	MOV	#lo_addr(_banRSI), W1
	MOV.B	#2, W0
	MOV.B	W0, [W1]
;SensorNivel.c,766 :: 		} else {
	GOTO	L_UART1Interrupt100
L_UART1Interrupt99:
;SensorNivel.c,767 :: 		banRSI = 0;
	MOV	#lo_addr(_banRSI), W1
	CLR	W0
	MOV.B	W0, [W1]
;SensorNivel.c,768 :: 		banRSC = 0;
	MOV	#lo_addr(_banRSC), W1
	CLR	W0
	MOV.B	W0, [W1]
;SensorNivel.c,769 :: 		i_rs485 = 0;
	CLR	W0
	MOV	W0, _i_rs485
;SensorNivel.c,775 :: 		}
L_UART1Interrupt100:
;SensorNivel.c,758 :: 		if ((banRSI==1)&&(i_rs485==5)){
L__UART1Interrupt117:
L__UART1Interrupt116:
;SensorNivel.c,779 :: 		if (banRSC==1){
	MOV	#lo_addr(_banRSC), W0
	MOV.B	[W0], W0
	CP.B	W0, #1
	BRA Z	L__UART1Interrupt183
	GOTO	L_UART1Interrupt101
L__UART1Interrupt183:
;SensorNivel.c,780 :: 		Delay_ms(100);                                                        //**Ojo: Este retardo es importante para que el Concentrador tenga tiempo de recibir la respuesta
	MOV	#21, W8
	MOV	#22619, W7
L_UART1Interrupt102:
	DEC	W7
	BRA NZ	L_UART1Interrupt102
	DEC	W8
	BRA NZ	L_UART1Interrupt102
;SensorNivel.c,784 :: 		banderaPeticion = 1;
	MOV	#lo_addr(_banderaPeticion), W1
	MOV.B	#1, W0
	MOV.B	W0, [W1]
;SensorNivel.c,786 :: 		banRSC = 0;
	MOV	#lo_addr(_banRSC), W1
	CLR	W0
	MOV.B	W0, [W1]
;SensorNivel.c,787 :: 		}
L_UART1Interrupt101:
;SensorNivel.c,788 :: 		}
L_end_UART1Interrupt:
	MOV	#26, W0
	REPEAT	#12
	POP	[W0--]
	POP	W0
	POP	RCOUNT
	POP	52
	RETFIE
; end of _UART1Interrupt
