Rodrig087/Vertedero-PCh/Software/RPi/C/LeerSensorNivel.c

//Compilar:
//gcc LeerSensorNivel.c -o leersensornivel -lbcm2835 -lwiringPi 
//gcc LeerSensorNivel.c -o /home/rsa/Ejecutables/leersensornivel -lbcm2835 -lwiringPi 

/*-------------------------------------------------------------------------------------------------------------------------
Autor: Milton Munoz
Fecha de creacion: 21/08/03
Observaciones:
Funcion 1: Inicio de medicion.
Funcion 2: Lectura de datos.
Funcion 3: Escritura de datos.
Funcion 4: Test comunicacion
        Subfuncion 1: Test SPI (sumRecibido=1645)
        Subfuncion 2: Test RS485 (sumRecibido=1805)
-------------------------------------------------------------------------------------------------------------------------*/

#include <stdio.h>
#include <stdlib.h>
#include <wiringPi.h>
#include <bcm2835.h>
#include <time.h>
#include <string.h>
#include <unistd.h>


//Declaracion de constantes
#define IDConcentrador 1
#define P0 0																	//Pin 11 GPIO
#define MCLR 28																	//Pin 38 GPIO
#define LEDTEST 29 																//Pin 40 GPIO																						
#define TIEMPO_SPI 100
#define FreqSPI 200000

#define RED   "\x1B[31m"
#define RESET "\x1B[0m"

//Declaracion de variables
unsigned int i, x;
unsigned char bufferSPI;

unsigned char idPet;
unsigned char funcionPet;
unsigned char subFuncionPet;
unsigned int numDatosPet;

unsigned char idResp;
unsigned char funcionResp;
unsigned char subFuncionResp;
unsigned int numDatosResp;
unsigned char *ptrNumDatosResp; //OJO: Funciono cambiando short por char

unsigned char payloadPet[20];
unsigned char payloadResp[2600];

unsigned int sumEnviado;
unsigned int sumRecibido;

FILE *fp;


//Declaracion de funciones
int ConfiguracionPrincipal();													
void EnviarSolicitud(unsigned char id, unsigned char funcion, unsigned char subFuncion, unsigned char numDatos, unsigned char* payload);
void RecibirRespuesta();
void RecibirPyloadRespuesta(unsigned int numBytesPyload, unsigned char* pyloadRS485);
void CrearArchivo(unsigned short idConc, unsigned short idNodo);
void GuardarTrama(unsigned char* tramaRS485, unsigned int longitudTrama); 	
void LeerTemperaturaSensor(unsigned char* tramaDatosShort, unsigned int longitudTramaShort);									
void ImprimirInformacion();
void Salir();						


int main(int argc, char *argv[]){

	//printf("Iniciando...\n");
	idPet = (char)(atoi(argv[1]));
  
	//Inicializa las variables:
	i = 0;
	x = 0;
	idResp = 0;
	funcionPet = 0;
	subFuncionResp = 0;
	numDatosResp = 0;
	ptrNumDatosResp = (unsigned char *) & numDatosResp;
	
	//Configuracion principal:
	ConfiguracionPrincipal();
	
	//idPet = 0;
	//funcionPet = 0;
	//subFuncionPet = 0;
	//numDatosPet = 0;
		
	
	//Datos de prueba:
	//idPet = 3;
	funcionPet = 2;
	subFuncionPet = 2;
	numDatosPet = 0;
	payloadPet[0] = 1;
	payloadPet[1] = 2;
	payloadPet[2] = 3;
	payloadPet[3] = 4;
	payloadPet[4] = 5;
	
	sumEnviado = 0;
	sumRecibido = 0;
	
	EnviarSolicitud(idPet, funcionPet, subFuncionPet, numDatosPet, payloadPet);
	
	while(1){}
	//Salir();	

}

//**************************************************************************************************************************************
//Configuracion:

int ConfiguracionPrincipal(){
	
    //Configuracion libreria bcm2835:
	if (!bcm2835_init()){
		printf("bcm2835_init fallo. Ejecuto el programa como root?\n");
		return 1;
    }
    if (!bcm2835_spi_begin()){
		printf("bcm2835_spi_begin fallo. Ejecuto el programa como root?\n");
		return 1;
    }

    bcm2835_spi_setBitOrder(BCM2835_SPI_BIT_ORDER_MSBFIRST);
    bcm2835_spi_setDataMode(BCM2835_SPI_MODE3);
	bcm2835_spi_setClockDivider(BCM2835_SPI_CLOCK_DIVIDER_256);					//Clock divider RPi 3		
	bcm2835_spi_set_speed_hz(FreqSPI);
    bcm2835_spi_chipSelect(BCM2835_SPI_CS0);
    bcm2835_spi_setChipSelectPolarity(BCM2835_SPI_CS0, LOW);
		
	//Configuracion libreria WiringPi:
    wiringPiSetup();
    pinMode(P0, INPUT);
	pinMode(MCLR, OUTPUT);
	pinMode(LEDTEST, OUTPUT);
	wiringPiISR (P0, INT_EDGE_RISING, RecibirRespuesta);
	
	//Enciende el pin LEDTEST:
	digitalWrite (LEDTEST, HIGH);
		
}
//**************************************************************************************************************************************

//Imprimir en pantalla los datos relevantes
void ImprimirInformacion(){
	
	//Imprime la solicitud:
	printf("\nTrama enviada:");
	printf("\n Cabecera: %d %d %d %d", idPet, funcionPet, subFuncionPet, numDatosPet);
		
	//Imprime la respuesta:
	printf("\nTrama recibida:");
	printf("\n Cabecera: %d %d %d %d", idResp, funcionResp, subFuncionResp, numDatosResp);
	
	//printf("\n Payload: ");
	//for (i=0;i<numDatosResp;i++){
	//	printf("%#02X ", payloadResp[i]);
	//}
	
			
	LeerTemperaturaSensor(payloadResp, numDatosResp);
	//system("python3 GraficarUltrasonido.py");
			
	Salir();
	
}

//**************************************************************************************************************************************
//Comunicacion RPi-dsPIC:

//Funcion para enviar la solicitud (C:0xA0 F:0xF0):
void EnviarSolicitud(unsigned char id, unsigned char funcion, unsigned char subFuncion, unsigned char numDatos, unsigned char* payload){
	
	//sumatoria de control:
	for (i=0;i<numDatos;i++){
        sumEnviado = sumEnviado + payload[i];
    }
	
	bcm2835_delayMicroseconds(200);
	
	//Envia la cabecera: [id, funcion, subfuncion, #Datos]:
	bcm2835_spi_transfer(0xA0);
	bcm2835_delayMicroseconds(TIEMPO_SPI);
	bcm2835_spi_transfer(id);
	bcm2835_delayMicroseconds(TIEMPO_SPI);
	bcm2835_spi_transfer(funcion);
	bcm2835_delayMicroseconds(TIEMPO_SPI);
	bcm2835_spi_transfer(subFuncion);
	bcm2835_delayMicroseconds(TIEMPO_SPI);
	bcm2835_spi_transfer(numDatos);
	bcm2835_spi_transfer(0x00);     //Envia este byte para simular el MSB de la variable numDatos. Es poco probable que una solicitud tenga un pyload de mas de 255 bytes.
	bcm2835_delayMicroseconds(TIEMPO_SPI);
	
	//Envia el payload:
	for (i=0;i<numDatos;i++){
        bcm2835_spi_transfer(payload[i]);
        bcm2835_delayMicroseconds(TIEMPO_SPI);
    }
		
	//Envia el delimitador de fin de trama:
	bcm2835_spi_transfer(0xF0);	
	bcm2835_delayMicroseconds(TIEMPO_SPI);
	
	//Imprime la solicitud:
	printf("\n>Solicitud enviada");
	
	//Enciende el LEDTEST:
	digitalWrite (LEDTEST, HIGH);
	
}


//Funcion para resibir la cabecera de respuesta C:0xA1 F:0xF1
void RecibirRespuesta(){
	
	bcm2835_delayMicroseconds(200);
	
	//Recupera la cabecera: [id, funcion, subfuncion, lsbNumDatos, msbNumDatos]:
	bcm2835_spi_transfer(0xA1);
	bcm2835_delayMicroseconds(TIEMPO_SPI);
	idResp = bcm2835_spi_transfer(0x00);
	bcm2835_delayMicroseconds(TIEMPO_SPI);
	funcionResp = bcm2835_spi_transfer(0x00);
	bcm2835_delayMicroseconds(TIEMPO_SPI);
	subFuncionResp = bcm2835_spi_transfer(0x00);
	bcm2835_delayMicroseconds(TIEMPO_SPI);
	*(ptrNumDatosResp) = bcm2835_spi_transfer(0x00);
	bcm2835_delayMicroseconds(TIEMPO_SPI);
	*(ptrNumDatosResp+1) = bcm2835_spi_transfer(0x00);
	bcm2835_delayMicroseconds(TIEMPO_SPI);
	bcm2835_spi_transfer(0xF1);	

	delay(25); //**Este retardo es muy importante**
	//Confirma si recibio la respuesta:
	printf("\n>Respuesta recibida\n");
	
	//Se recupera el payload de la respuesta:
	RecibirPyloadRespuesta(numDatosResp, payloadResp);	
	CrearArchivo(IDConcentrador, idResp);
	GuardarTrama(payloadResp, numDatosResp);
		
				
	//Apaga el LEDTEST:
	digitalWrite (LEDTEST, LOW);
	
	//Imprime la informacion de solicitud y respuesta:
	ImprimirInformacion();
	
	//Salir();
		
}

//Funcion para recibir el pyload de respuesta (C:0xA2 F:0xF2):
void RecibirPyloadRespuesta(unsigned int numBytesPyload, unsigned char* pyloadRS485){
	
	//printf("\nRecuperando pyload...\n");
	bcm2835_spi_transfer(0xA2);
	bcm2835_delayMicroseconds(TIEMPO_SPI);
	for (i=0;i<numBytesPyload;i++){
        bufferSPI = bcm2835_spi_transfer(0x00);
        pyloadRS485[i] = bufferSPI;
        bcm2835_delayMicroseconds(TIEMPO_SPI);
    }
	bcm2835_spi_transfer(0xF2);
	bcm2835_delayMicroseconds(TIEMPO_SPI);
	
}	

//**************************************************************************************************************************************

//**************************************************************************************************************************************
//Manejo de archivos binarios:

void CrearArchivo(unsigned short idConc, unsigned short idNodo){

	char nombreArchivo[60];
	char idArchivo[10];
	char tiempoMedicion[7];
	char tiempoMedicionStr[25];
	char ext[5];
	
	//Obtiene la hora y la fecha del sistema:
	time_t t;
	struct tm *tm;
	t=time(NULL);
	tm=localtime(&t);
	tiempoMedicion[0] = tm->tm_year-100;											//Anio (contado desde 1900)
	tiempoMedicion[1] = tm->tm_mon+1;												//Mes desde Enero (0-11)
	tiempoMedicion[2] = tm->tm_mday;												//Dia del mes (0-31)
	tiempoMedicion[3] = tm->tm_hour;												//Hora
	tiempoMedicion[4] = tm->tm_min;													//Minuto
	tiempoMedicion[5] = tm->tm_sec;													//Segundo 
			
	//Realiza la concatenacion para obtner el nombre del archivo:			
	strcpy(nombreArchivo, "/home/rsa/Mediciones/Vertederos/");
	sprintf(idArchivo, "C%0.2dN%0.2d_", idConc, idNodo); 
	sprintf(tiempoMedicionStr, "%0.2d%0.2d%0.2d-%0.2d%0.2d%0.2d", tiempoMedicion[0], tiempoMedicion[1], tiempoMedicion[2], tiempoMedicion[3], tiempoMedicion[4], tiempoMedicion[5]);
	strcpy(ext, ".dat");
	strcat(nombreArchivo, idArchivo);
	strcat(nombreArchivo, tiempoMedicionStr);
	strcat(nombreArchivo, ext); 
	
	//Crea el archivo binario:
	printf("Se ha creado el archivo: %s\n", nombreArchivo);
	fp = fopen (nombreArchivo, "wb+");
	
}

void GuardarTrama(unsigned char* tramaRS485, unsigned int longitudTrama){
		
	unsigned int outFwrite;
					
	//Guarda la trama en el archivo binario:
	if (fp!=NULL){
		do{
		outFwrite = fwrite(tramaRS485, sizeof(char), longitudTrama, fp);
		} while (outFwrite!=longitudTrama);
		fflush(fp);
	} else {
		printf("No se pudo escribir el archivo binario\n");
	}
		
}

void LeerTemperaturaSensor(unsigned char* tramaDatosShort, unsigned int longitudTramaShort){
	
	char signoTemp;
	unsigned char temperaturaLSB;
	unsigned char temperaturaMSB;
	unsigned int temperaturaRaw, temperaturaInt;
	float temperaturaFloat, temperaturaSensor; 
	
	//Obtiene los bytes de temperatura de la trama:
	temperaturaLSB = tramaDatosShort[longitudTramaShort - 2];
	temperaturaMSB = tramaDatosShort[longitudTramaShort - 1];
	temperaturaRaw = ((temperaturaMSB << 8) & 0xFF00) + ((temperaturaLSB) & 0xFF);
	//Verifica si la temperatura es negativa:
	if (temperaturaRaw & 0x8000){
		signoTemp = -1;
		temperaturaRaw = ~temperaturaRaw + 1;
	}else{
		signoTemp = 1;
		
	}
	//Calcula la parte entera de la temperatura:
	temperaturaInt = (temperaturaRaw >> 4) * signoTemp;
	//Calcula la parte decimal de la temperatura:
	temperaturaFloat = ((temperaturaRaw & 0x000F) * 625) / 10000.0;
	//Calcula la temperatura:
	temperaturaSensor = temperaturaInt + temperaturaFloat;
	//Imprime los datos de temperatura:
	//printf("\n Temperatura LSB: %#02X", temperaturaLSB);
	//printf("\n Temperatura MSB: %#02X", temperaturaMSB);
	//printf("\n Temperatura Raw: %#04X", temperaturaRaw);
	printf("\n Temperatura sensor: %f", temperaturaSensor);
	
}


//**************************************************************************************************************************************

//**************************************************************************************************************************************
//Procesos locales:

void Salir(){
	
	bcm2835_spi_end();
	bcm2835_close();
	printf("\nAdios...\n");
	exit (-1);
}

//**************************************************************************************************************************************
