Rodrig087/Vertedero-PCh/Firmware/Librerias/RS485.c

//Libreria para la comunicacion a travez de RS485
//Version 2: Esta version recibe como parametros el puerto, la trama de cabecera y la trama pdu

/////////////////////////////////// Formato de la trama de datos ///////////////////////////////////
//| byteInicio |                     Cabecera                    |     Payload     |   bytesFin   |
//|   1 byte   |   1 byte  |  1 byte   |    1 byte    |  1 byte  |     n bytes     |    2 bytes   |
//|    0x3A    | Direccion |  Funcion  |  Subfuncion  |  #Datos  |     Payload     |  0Dh  |  0Ah |


// Definicion de pines del chip select, en el programa que se va a utilizar la
// libreria hay que declarar este pin del CS
//sbit MS1RS485 at LATC5_bit; 
extern sfr sbit MSRS485;
extern sfr sbit MSRS485_Direction;

//*****************************************************************************************************************************************

//Funcion para enviar una trama de n datos a travez del MAX485
void EnviarTramaRS485(unsigned char puertoUART, unsigned char *cabecera, unsigned char *payload){

     unsigned char direccion; 
	 unsigned char funcion; 
	 unsigned char subfuncion; 
	 unsigned char lsbNumDatos;
	 unsigned char msbNumDatos;
	 unsigned int iDatos;
	 	 
	 //Variables y asignacion para trabajar con punteros:
	 unsigned int numDatos;
	 unsigned char *ptrnumDatos;
	 ptrnumDatos = (unsigned char *) & numDatos;
	 
	 //Se realiza el cast de los datos int para convertirlos a char:
	 direccion = cabecera[0];
	 funcion = cabecera[1];
	 subfuncion = cabecera[2];
	 lsbNumDatos = cabecera[3];
	 msbNumDatos = cabecera[4];
	 
	 //Se realiza el calculo del numero de datos:
	 *(ptrnumDatos) = lsbNumDatos;
	 *(ptrnumDatos+1) = msbNumDatos;
	                      
     if (puertoUART == 1){
        MSRS485 = 1;                                                            //Establece el Max485 en modo escritura
        UART1_Write(0x3A);                                                      //Envia la cabecera de la trama
        UART1_Write(direccion);                                                 //Envia la direccion del destinatario
        UART1_Write(funcion);                                                   //Envia el codigo de la funcion
        UART1_Write(subfuncion);                                                //Envia el codigo de la subfuncion
        UART1_Write(lsbNumDatos);                                               //Envia el LSB del numero de datos
        UART1_Write(msbNumDatos);                                               //Envia el MSB del numero de datos
		for (iDatos=0;iDatos<numDatos;iDatos++){                                //Envia la carga util de datos
            UART1_Write(payload[iDatos]);
        }
        UART1_Write(0x0D);                                                      //Envia el primer delimitador de final de la trama
        UART1_Write(0x0A);                                                      //Envia el segundo delimitador de final de la trama
        UART1_Write(0x00);                                                      //Envia un byte adicional
        while(UART1_Tx_Idle()==0);                                              //Espera hasta que se haya terminado de enviar todo el dato por UART antes de continuar
        MSRS485 = 0;                                                           //Establece el Max485 en modo lectura
     }

}

//*****************************************************************************************************************************************
