Rodrig087/Vertedero-PCh/(commit log)

2021-10-06 Se implementaron los PCBs del sensor y el transductor. Se puso en funcionamiento el Firmware del sensor de nivel desarrollado en la tesis, cambiando algunos metodos, y borrando e implementando unos n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
    [Lista de materiales.xlsx, SensorNivel.cfg, Trd_pcb.brd, Trd_pcb.sch, sensor_dsp.brd, sensor_dsp.sch]
2021-10-12 Se implmento un programa que convierte el vector de enteros de muestras y envolvente en un vector de shorts para enviarlo por RS485. Se encontro que es necesario modificar la libreria de comunicacion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
    [SensorNivel.asm, SensorNivel.c]
2021-10-20 Se modifico el firmware del sensor del nivel para trabajar con numeros de datos de 2 bytes. Se comprobo enviando una trama de prueba de 512bytes y funciona bien.
2021-10-25 Se esta trabajando para graficar la señal muestreada y la señal filtrada.
2021-10-26 Punto de control. No funciona el muestreo. Voy a cambiar la logica del firmware. Parece que el problema es tener la interrupcion de muestreo dentro de la interrupcion de la comunicacion y que la prio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
    [IniciarMedicion.c, InspeccionarUltrasonido.c, SensorNivel.asm, SensorNivel.c]
2021-10-27 VERSION INSTALABLE. Se corrigieron las fallas del firmware.
    [IniciarMedicion.c, InspeccionarUltrasonido.c, LeerDS18.c, LeerDistancia.c, SensorNivel.asm, SensorNivel.c]
2021-10-27 Se esta implementando un software en Python para obtener la envolvente de la senal ultrasonica.
2021-11-08 Se implementaron unos programas en Python para analisdar la senal ultrasonica y un programa en C para realizar un proceso de medicion del vertedero de forma automatica
2021-11-09 Inicio de ejemplo de correlacion cruzada
2021-11-09 Se completo el programa que calcula el desfase entre la senal medida y una senal de referencia mediante correlacion cruzada. Funciona bien.
2021-11-10 Se agrego un programa de prueba que genera un tren de pulsos y realiza su filtrado pasa-banda para tomarlo como referencia para las mediciones. Se edito el programa CorrelacionUltrasonido.py para agr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
2021-11-12 Se modifico el programa AnalisisTemperatura-Distancia.py para realizar un analisis que permita establecer los valores de calibracion de TOF y temperatura en base a las mediciones de referencia. Luego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
2021-11-16 1. Version correlacion para Rpi. 2. Instrucciones de instalacion de scipy, numpy y python 3.8 para Rpi. 3. Inicio calibracion dht22 Arduino.
2021-11-16 Se implemento y modifico un programa en Arduino para leer un sensor DHT22 y un sensor DS18B20 y mostrar sus valores en un LCD-Nokia-5110
2021-11-17 Se corrigio el programa en Arduino LeerSensoresTempHumd y se comprobo que los sensores funcionan bien.
    [LeerSensoresTempHumd.ino]
2021-11-17 Se implemento un programa que genera la senal de referencia y la guarda en un archivo binario utilizando las herramientas de numpy
2021-11-19 Se modifico el programa CorrelacionUltrasonido.py para la RPi, para incluir el archivo de referencia.
2021-11-19 Se edito el programa ProcesarUltrasonido.py para mostrar el funcionamiento de los 2 metodos de calculo de TOF mediante deteccion de envolvente. Luego se cambio el nombre de este programa a MetodosDet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
2021-11-22 Se agregaron los planos en CAD de las estructuras metalicas de los vertederos
    [Chapa.DWG, Chapa.SLDDRW, Frente.SLDPRT]
2021-11-26 Se rediseñaron y corrigieron los diseños de los PCB. Se diseñaron las platinas de los vertederos basadas en las medidas de los soportes.
    [Frente.SLDPRT, Pieza1 V1.SLDPRT, Pieza1.SLDDRW, Pieza1.SLDPRT, Pieza1_V30.DWG, Pieza1_V90.DWG, Pieza2.SLDDRW, Pieza2.SLDPRT]
2022-01-04 Inicio de programa para calcular el nivel a partir de los archivos binarios en W10
2022-01-06 Se termino de implementar el programa que calcula la distancia a partir de los datos de todos los archivos binarios generados por el sensor de nivel
2022-01-06 Se actualizo el programa para graficar y guardar en un archivo de texto los datos de las mediciones de distancia y temperatura a partir de los archivos binarios del sensor de nivel.
2022-03-25 Se hicieron modificaciones al Firmware y al Software. Version funcional.
    [SensorNivel.cfg, sensor_dsp.brd, sensor_dsp.sch]
2022-05-06 Se agregaron programas para calcular la correlacion y para inspeccionar la señal ultrasonica. Version instalada en la presa
2022-05-17 Se modifico el firmware test/SensorNivel para comprobar el funcionamiento del TMR3 (funciona). Se realizaron algunos cambios en el programa LeerDS18.c (no funciona)
